tfagerholm/SIU-Scenery-Robot-V1/EET Research/Edge Detection Documents/Pictures/Dog collar disassembly/Step 2.PNG

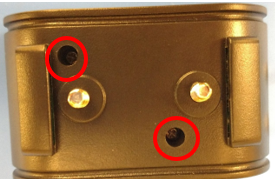
EET Research/Edge Detection Documents/Pictures/Dog collar disassembly/Step 2.PNG
