tfagerholm/SIU-Scenery-Robot-V1/Hardware/Jazzy Select motors & Wheels/Warner WR220 brakes.docx

Warner WR220 brakes

WR220 series brakes

FEATURES

The WR220 VAR22 brakes are an extremely compact design

Intended for use in static applications

1,5 Nm Torque

Maximum hub bore 10 mm

51,5 mm shell diameter

Manual release left or right, optional switch

Optional plastic lever cover

RoHS compliance

Typical Applications

Scooters/Wheelchairs

Patient hoists

Handheld power tools

Conveyors

Machine tools

Robotics

Floor sweepers/cleaners
