tfagerholm/SIU-Scenery-Robot-V1/Hardware/Jazzy Select motors & Wheels/GS35d 05-01&02.pdf

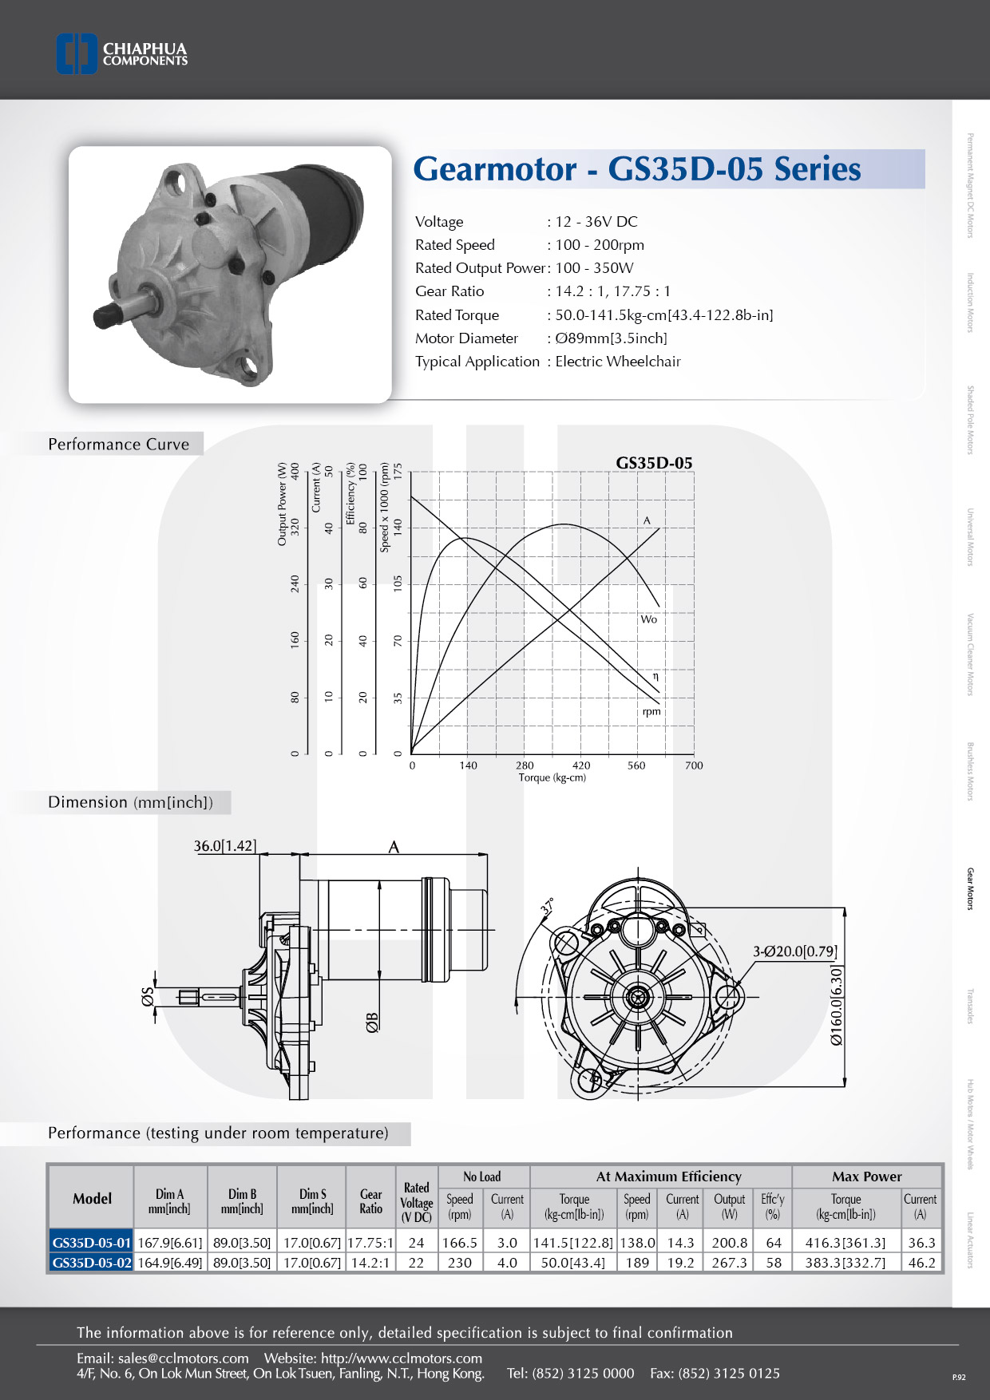
[picture p27: page 1]
