tfagerholm/SIU-Scenery-Robot-V1/Hardware/Jazzy Select motors & Wheels/GS35d 05.pdf

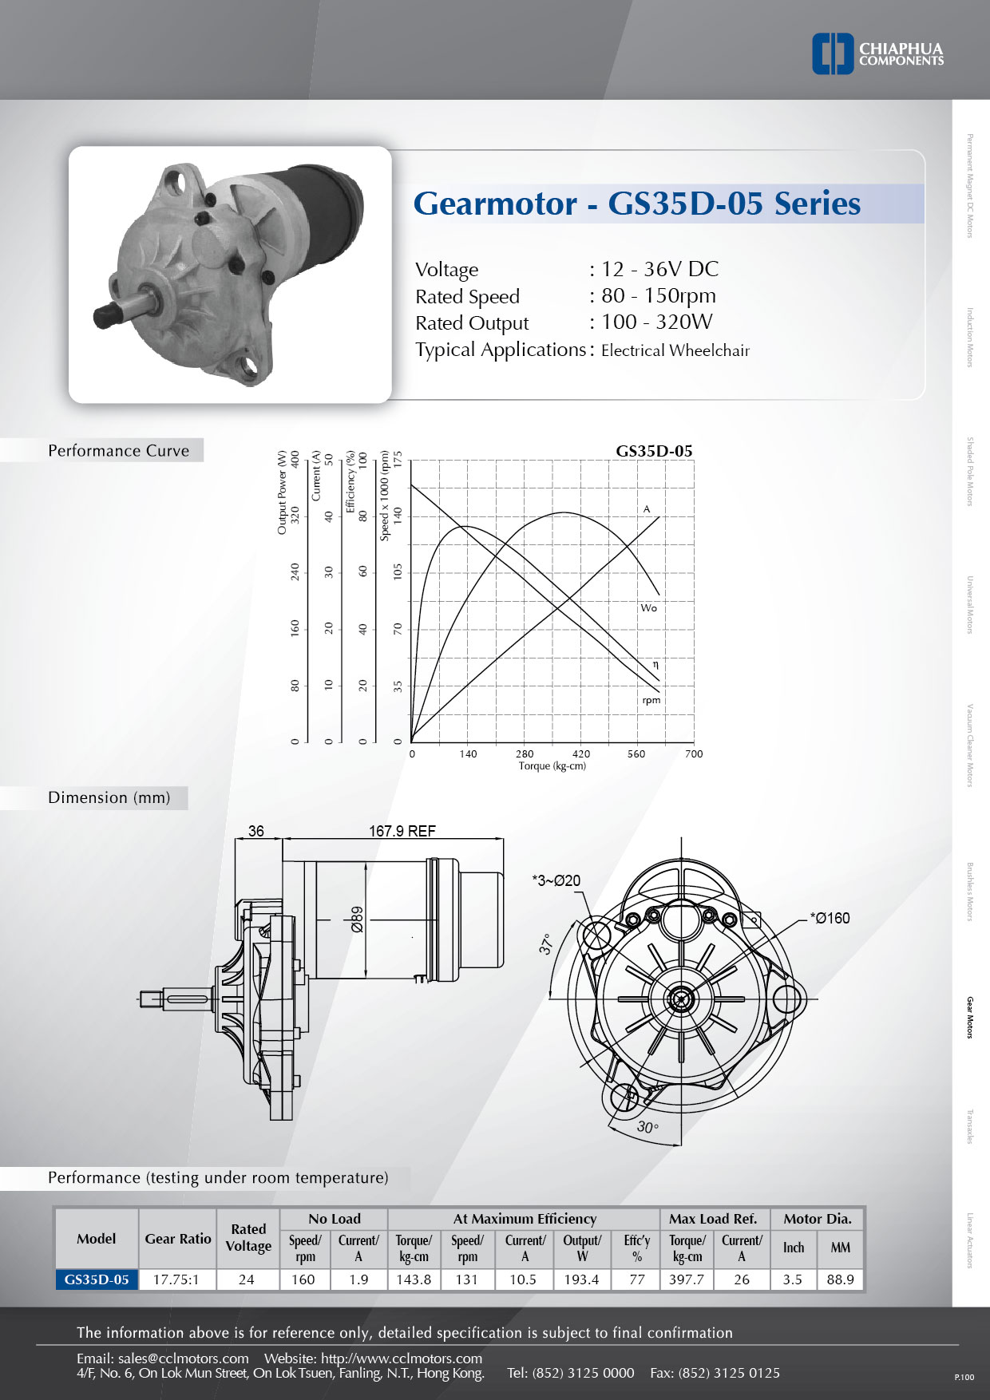
[picture p28: page 1]
