tfagerholm/SIU-Scenery-Robot-V1/EET Research/Connection Diagram.jpg

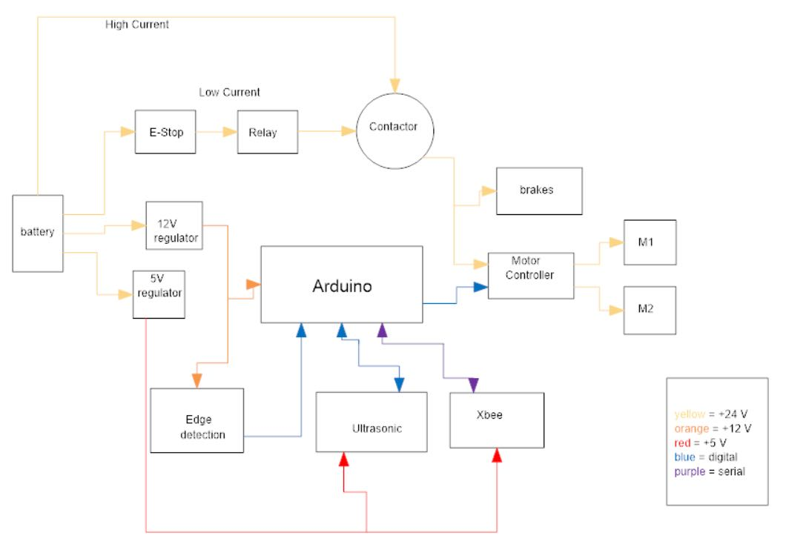
EET Research/Connection Diagram.jpg
