tfagerholm/SIU-Scenery-Robot-V1/EET Research/Edge Detection Documents/Pictures/Annotated board.PNG

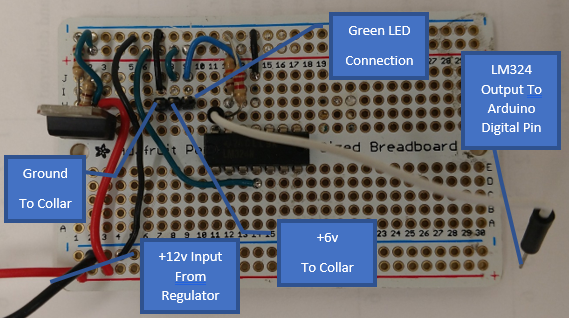
EET Research/Edge Detection Documents/Pictures/Annotated board.PNG
