tfagerholm/SIU-Scenery-Robot-V1/EET Research/Edge Detection Documents/Pictures/Annotated collar.PNG

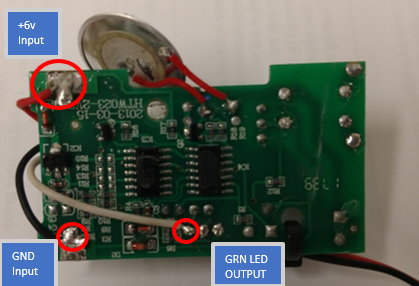
EET Research/Edge Detection Documents/Pictures/Annotated collar.PNG
