tfagerholm/SIU-Scenery-Robot-V1/EET Research/Edge Detection Documents/Pictures/IMG_20180507_153410372.jpg

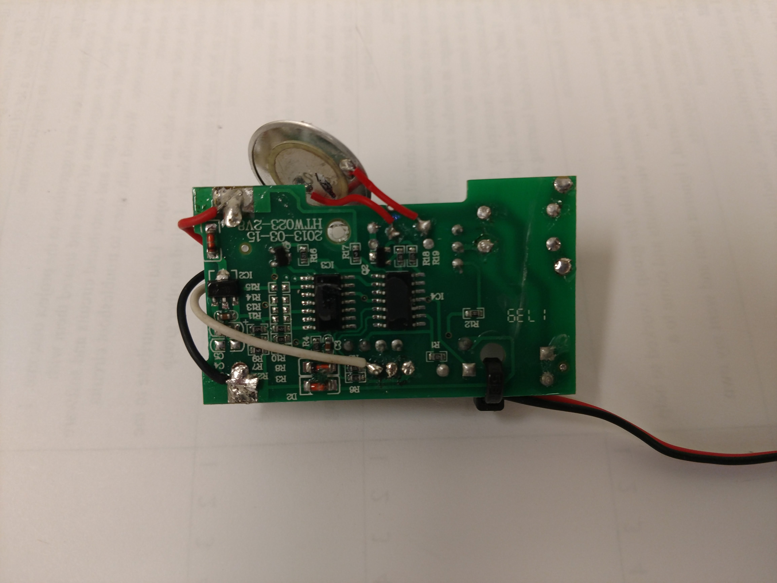
EET Research/Edge Detection Documents/Pictures/IMG_20180507_153410372.jpg
