tfagerholm/SIU-Scenery-Robot-V1/Photos/3D ISO of Frame.jpg

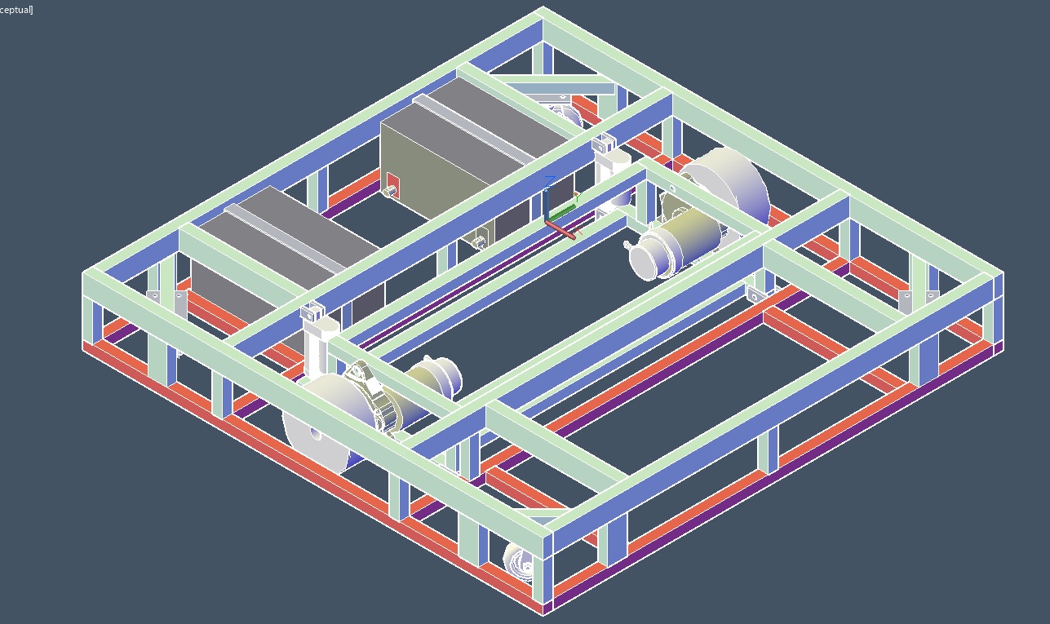
Photos/3D ISO of Frame.jpg
