tfagerholm/SIU-Scenery-Robot-V1/Photos/20190201_011459765_iOS.jpg

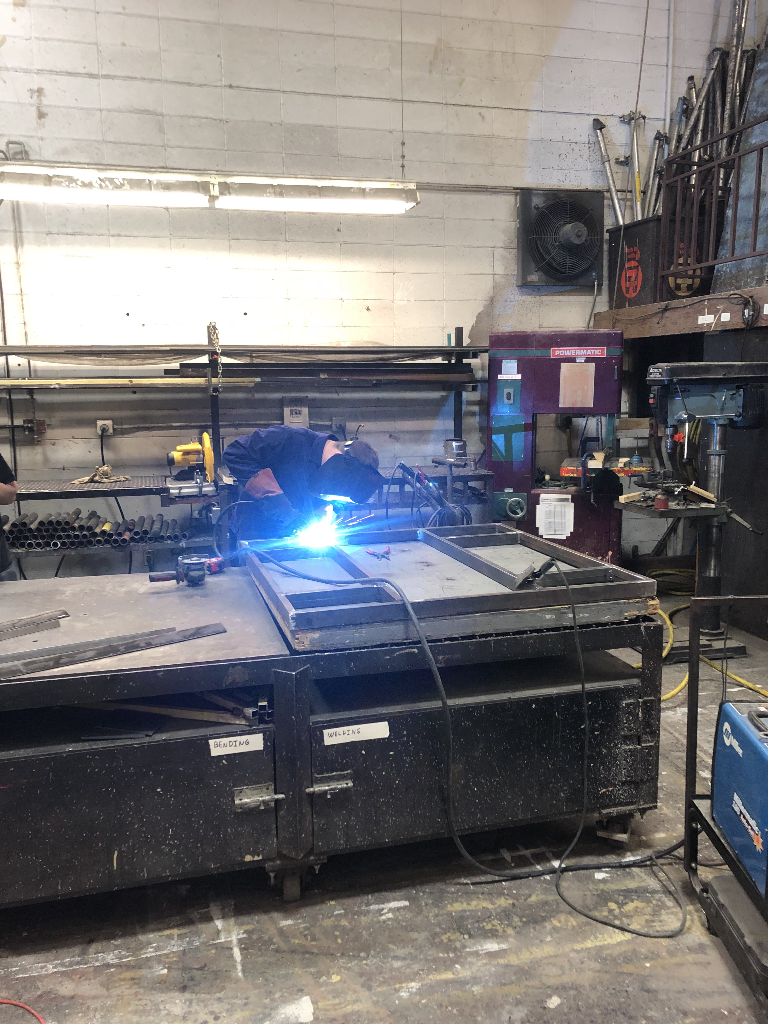
Photos/20190201_011459765_iOS.jpg
