tfagerholm/SIU-Scenery-Robot-V1/Photos/20190201_011505297_iOS.jpg

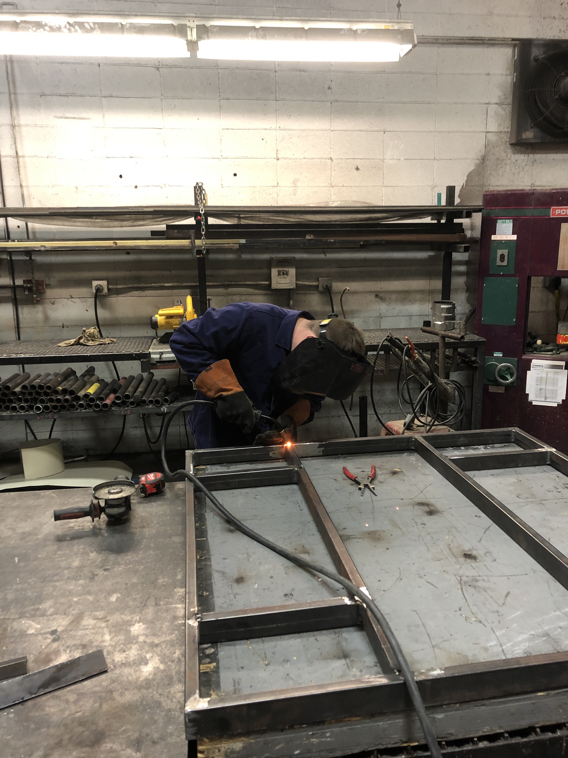
Photos/20190201_011505297_iOS.jpg
