tfagerholm/SIU-Scenery-Robot-V1/Photos/20190208_004331092_iOS.jpg

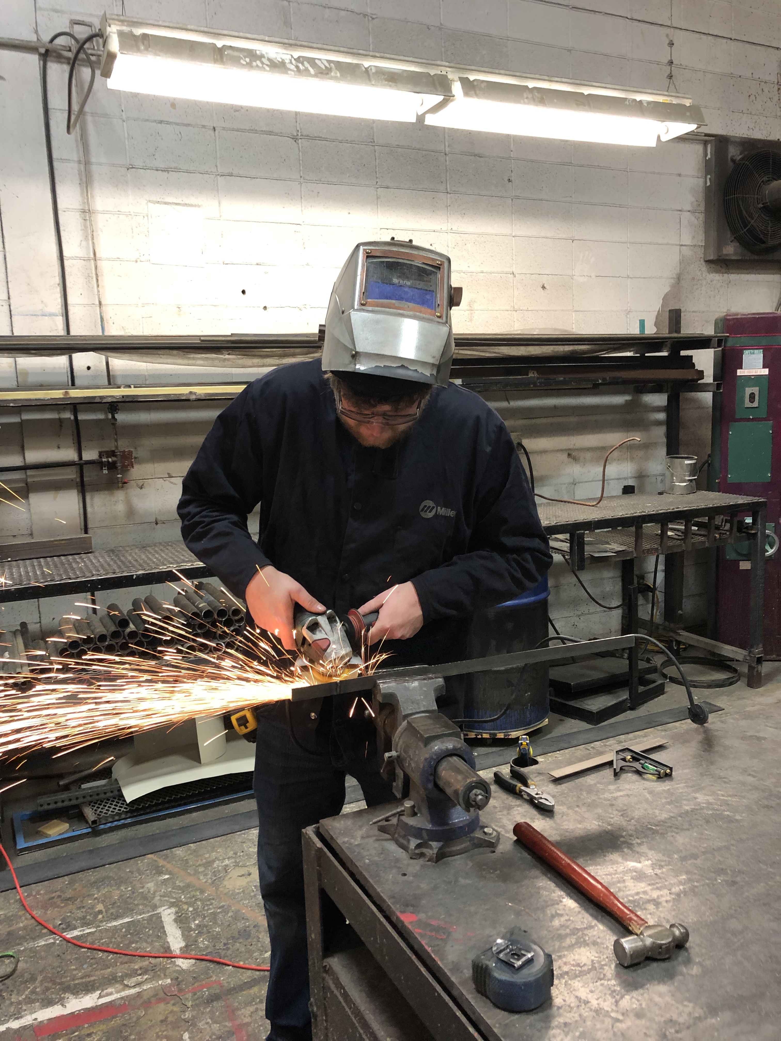
Photos/20190208_004331092_iOS.jpg
