tfagerholm/SIU-Scenery-Robot-V1/Photos/20190208_004505060_iOS.jpg

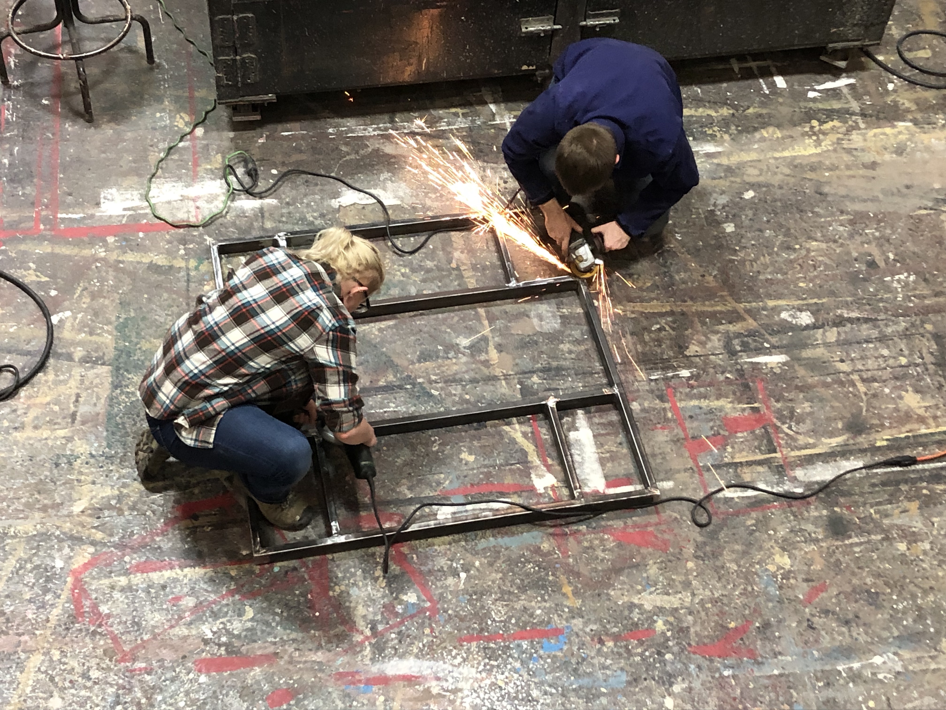
Photos/20190208_004505060_iOS.jpg
