tfagerholm/SIU-Scenery-Robot-V1/Photos/20190208_004511723_iOS.jpg

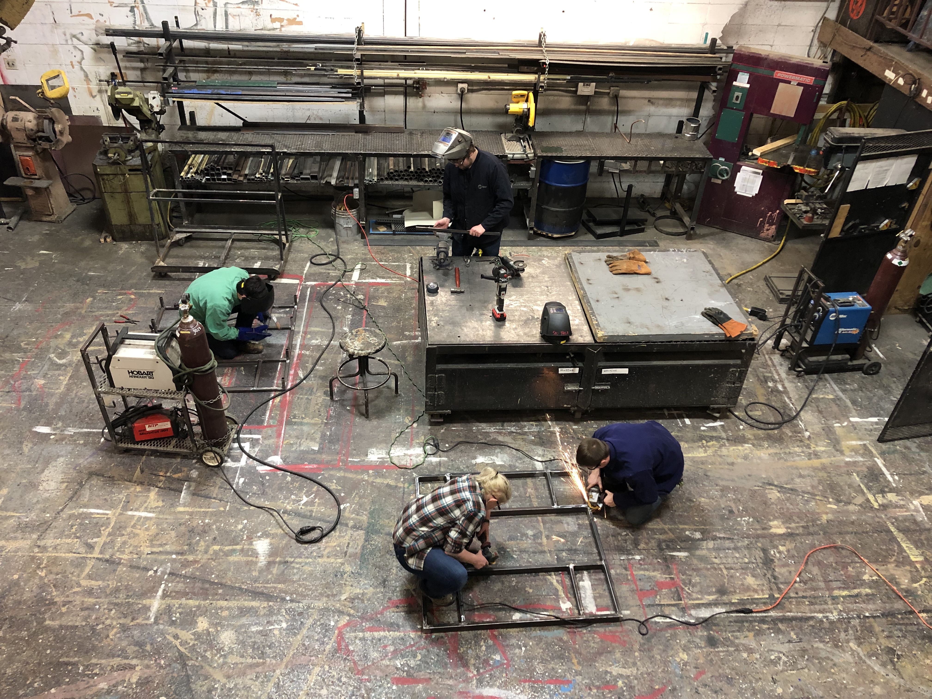
Photos/20190208_004511723_iOS.jpg
