tfagerholm/SIU-Scenery-Robot-V1/Photos/20190307_213836701_iOS.jpg

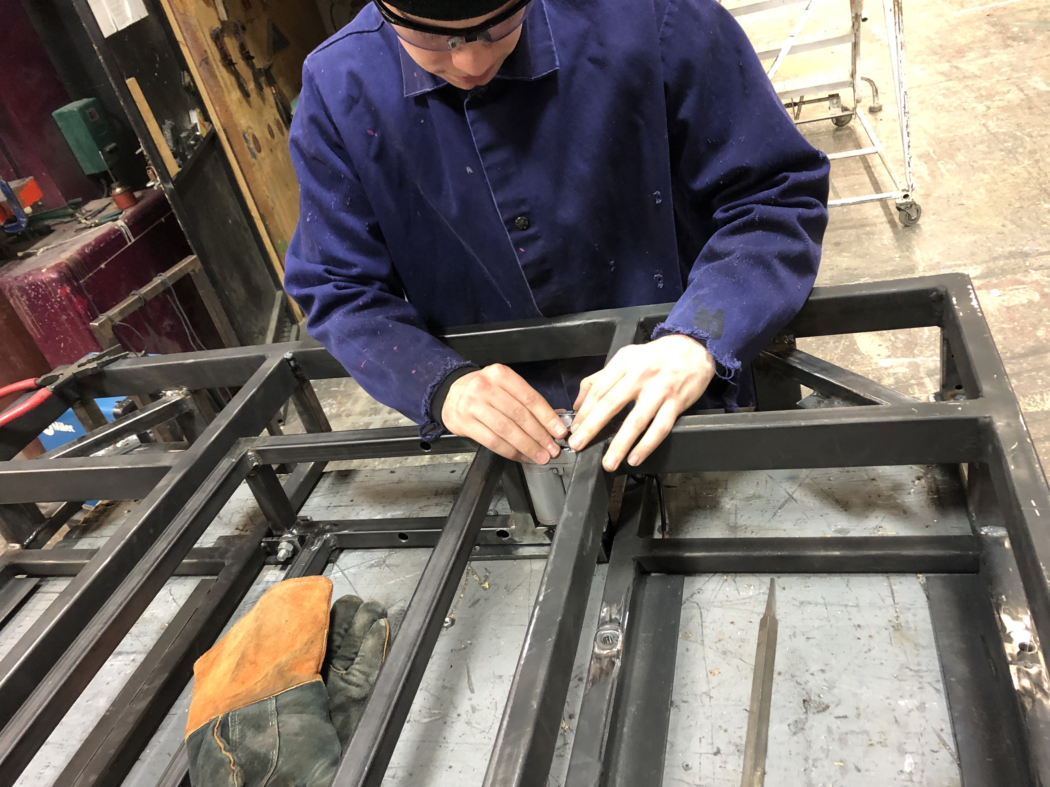
Photos/20190307_213836701_iOS.jpg
