tfagerholm/SIU-Scenery-Robot-V1/Photos/20190307_213838659_iOS.jpg

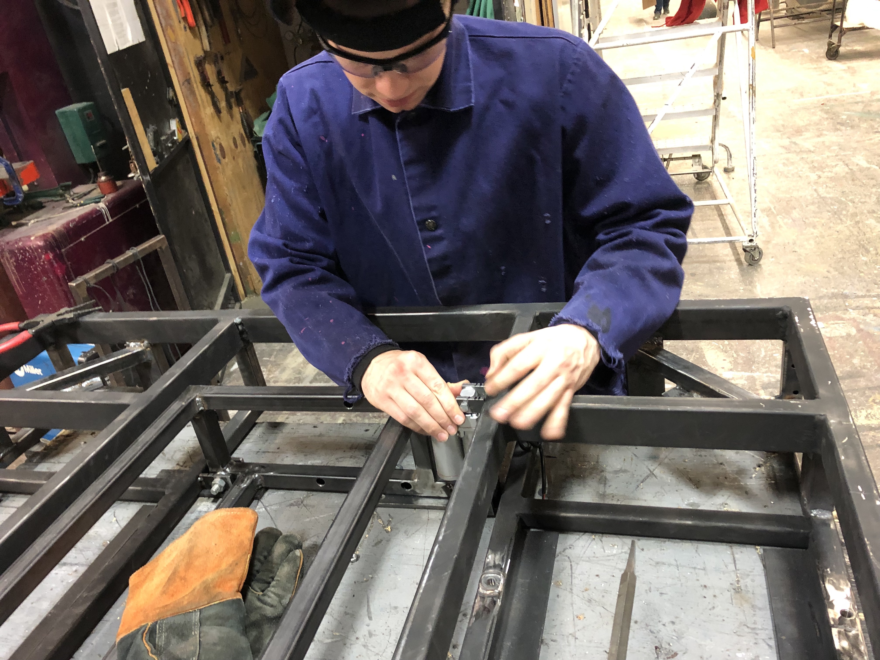
Photos/20190307_213838659_iOS.jpg
