tfagerholm/SIU-Scenery-Robot-V1/Photos/20190308_003058774_iOS.jpg

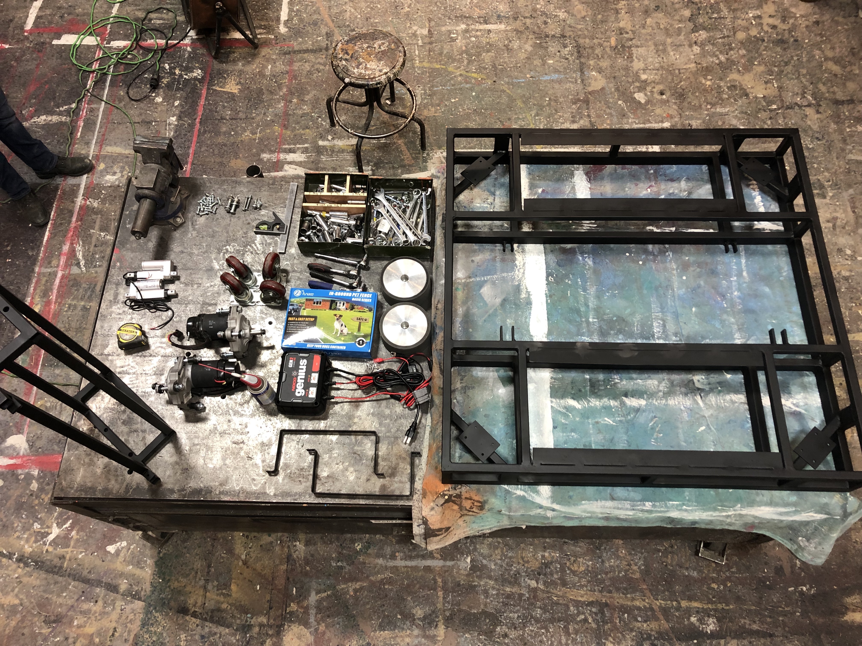
Photos/20190308_003058774_iOS.jpg
