tfagerholm/SIU-Scenery-Robot-V1/Photos/20190308_003123069_iOS.jpg

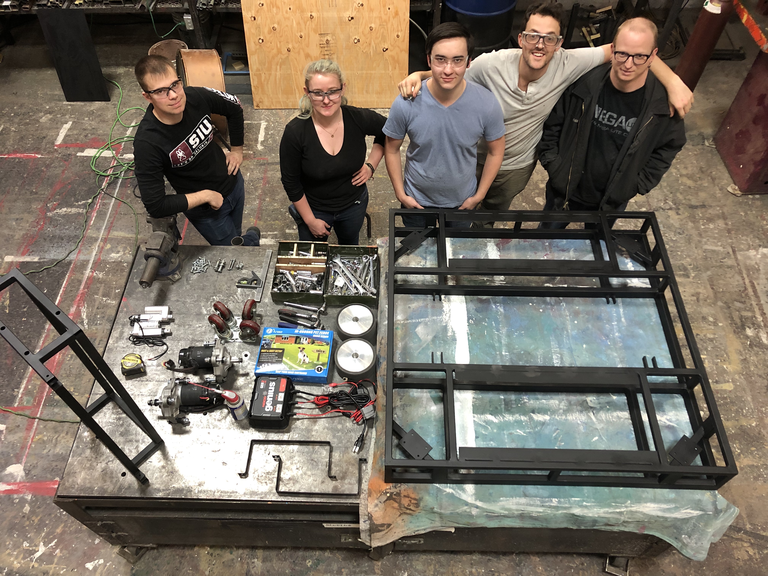
Photos/20190308_003123069_iOS.jpg
