tfagerholm/SIU-Scenery-Robot-V1/Photos/20190308_003128968_iOS.jpg

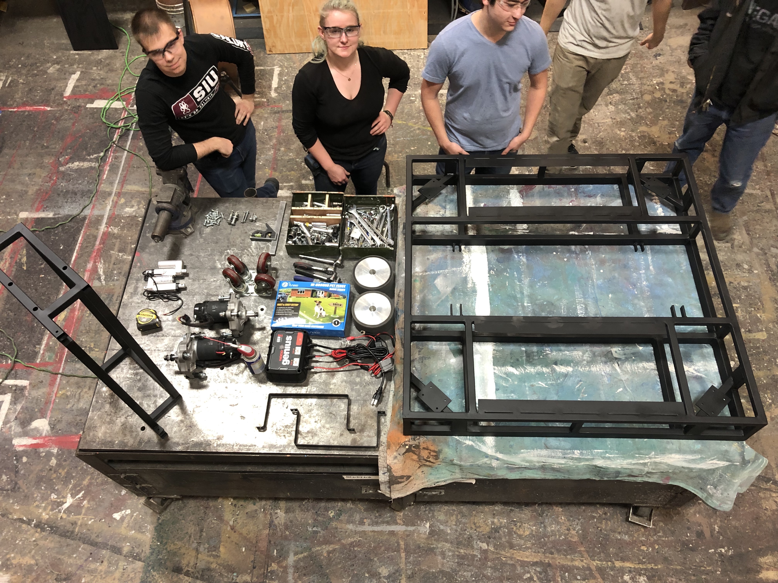
Photos/20190308_003128968_iOS.jpg
