tfagerholm/SIU-Scenery-Robot-V1/Photos/IMG_0376.JPG

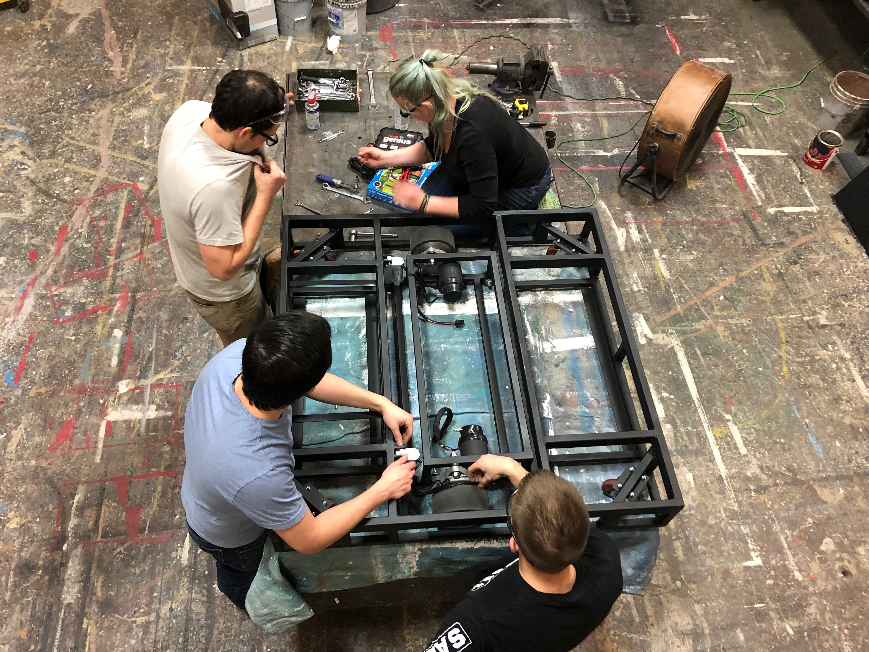
Photos/IMG_0376.JPG
