tfagerholm/SIU-Scenery-Robot-V1/Photos/IMG_0388.JPG

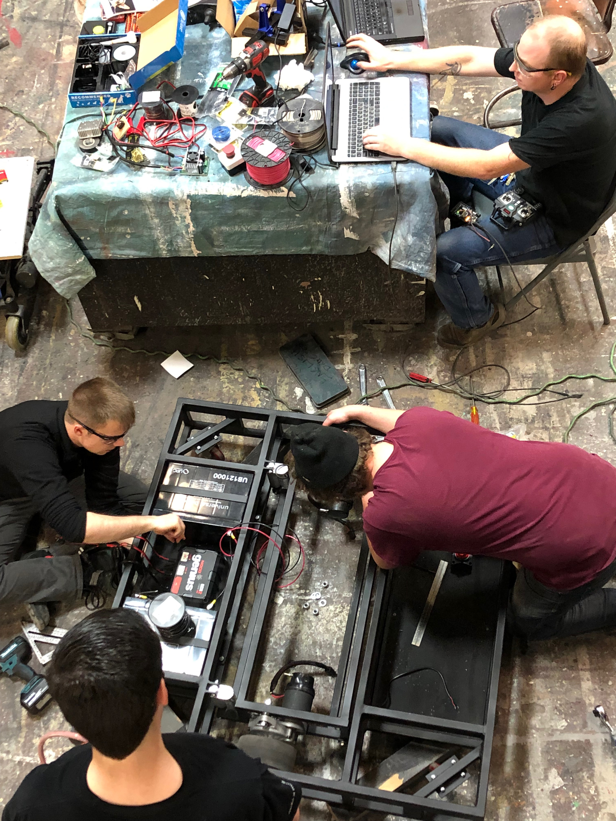
Photos/IMG_0388.JPG
