tfagerholm/SIU-Scenery-Robot-V1/Photos/IMG_0403.jpg

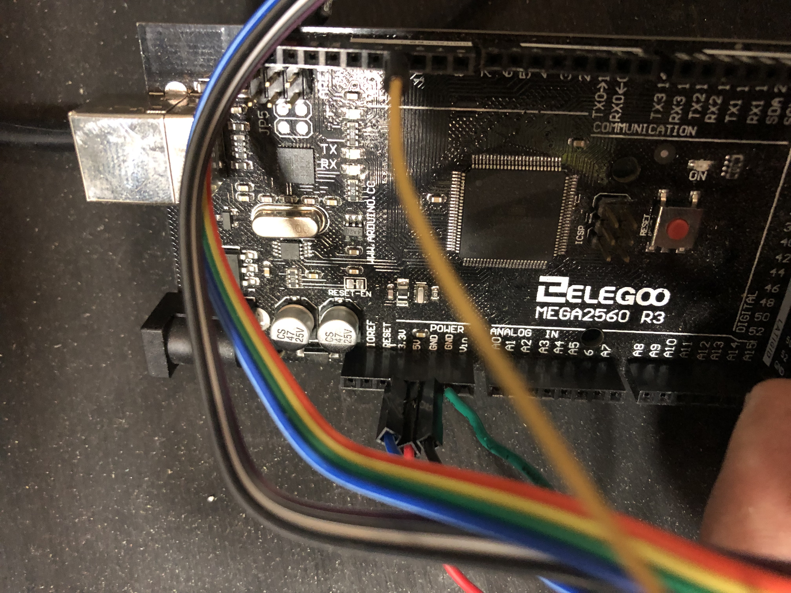
Photos/IMG_0403.jpg
