tfagerholm/SIU-Scenery-Robot-V1/Photos/IMG_0404.jpg

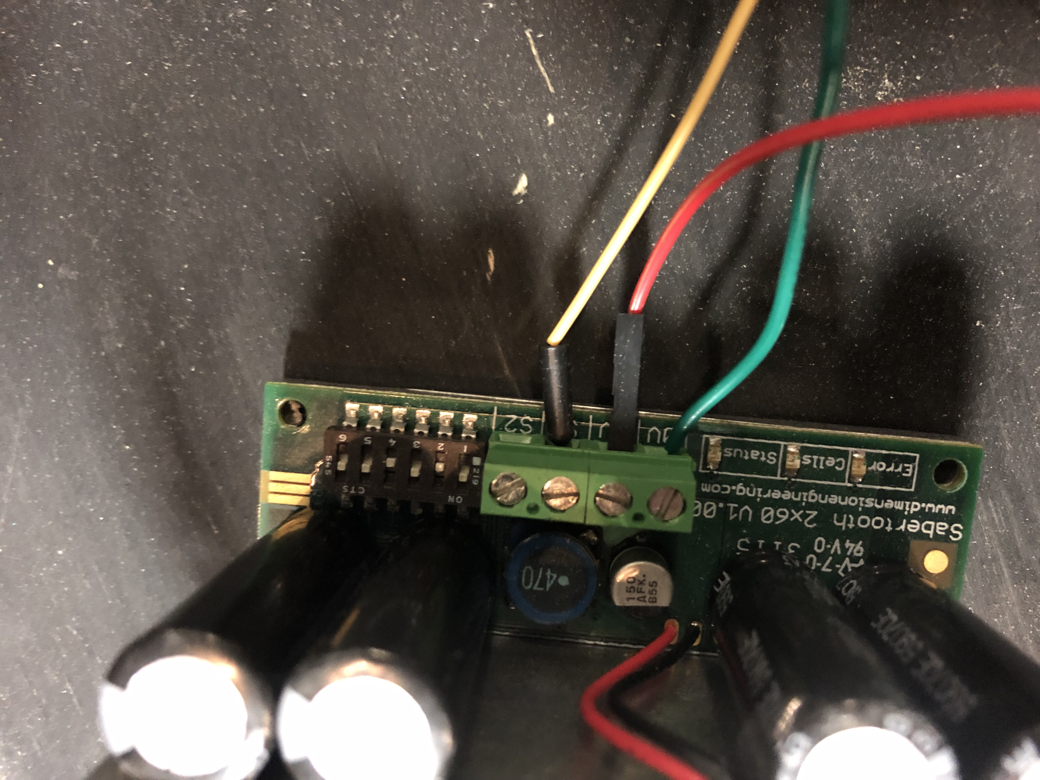
Photos/IMG_0404.jpg
