tfagerholm/SIU-Scenery-Robot-V1/Photos/IMG_0405.jpg

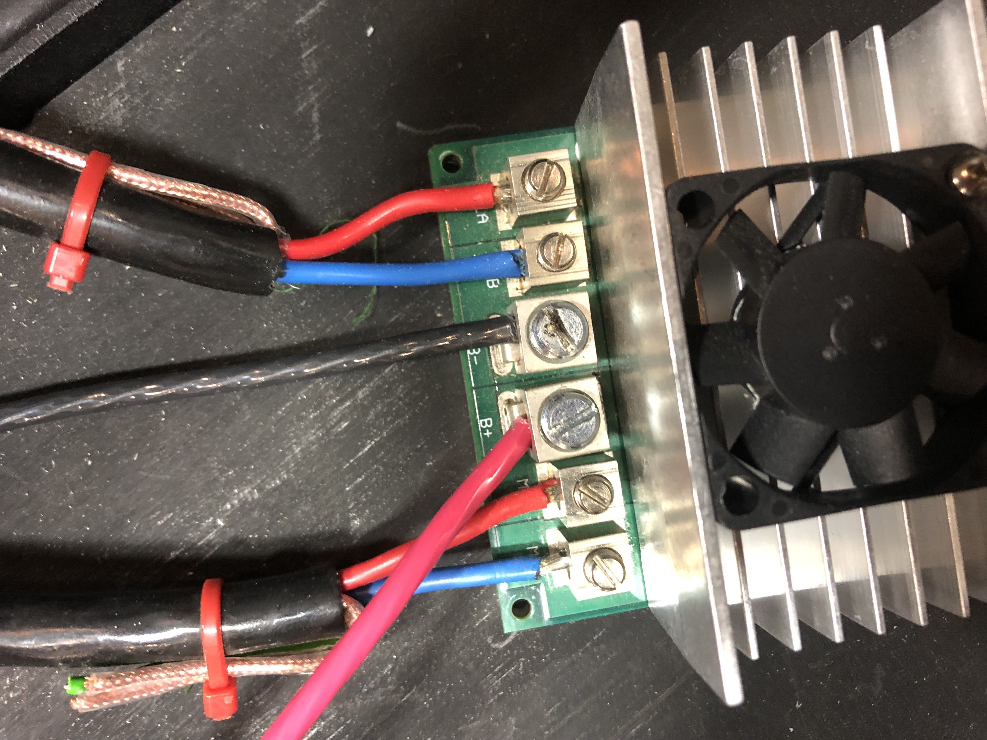
Photos/IMG_0405.jpg
