tfagerholm/SIU-Scenery-Robot-V1/Photos/IMG_0411.jpg

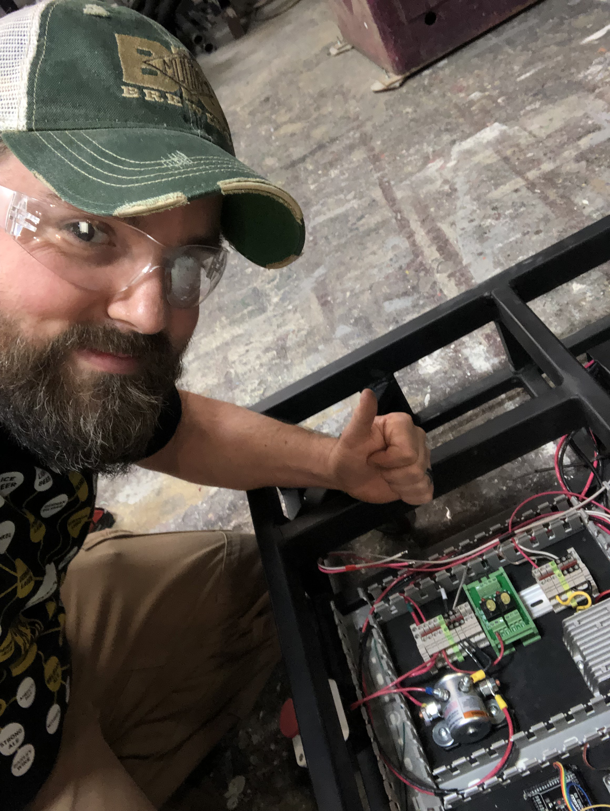
Photos/IMG_0411.jpg
