tfagerholm/SIU-Scenery-Robot-V1/Photos/IMG_0412(Edited).jpg

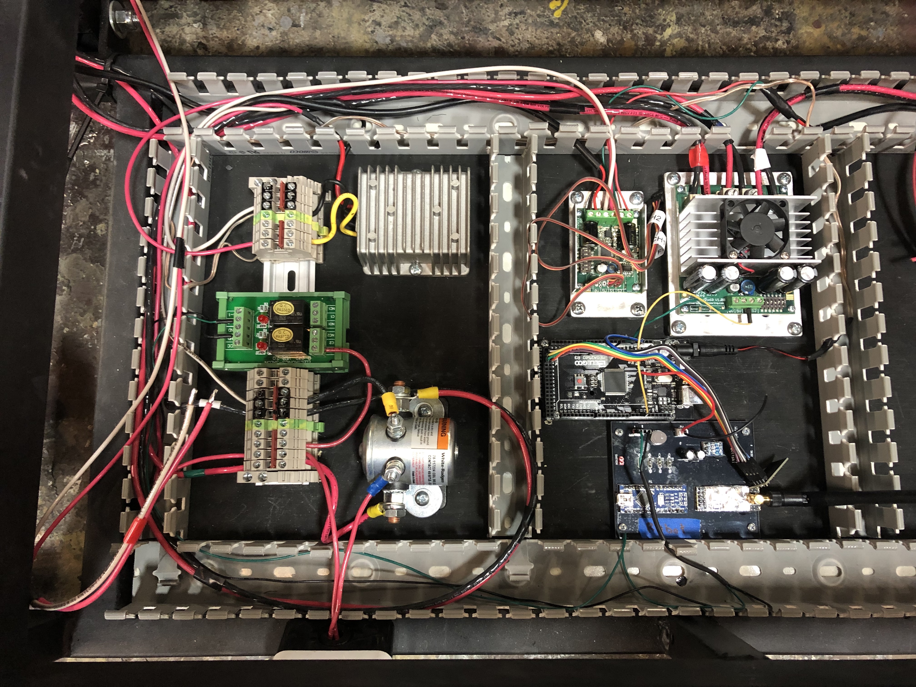
Photos/IMG_0412(Edited).jpg
