tfagerholm/SIU-Scenery-Robot-V1/Photos/IMG_0413(Edited).jpg

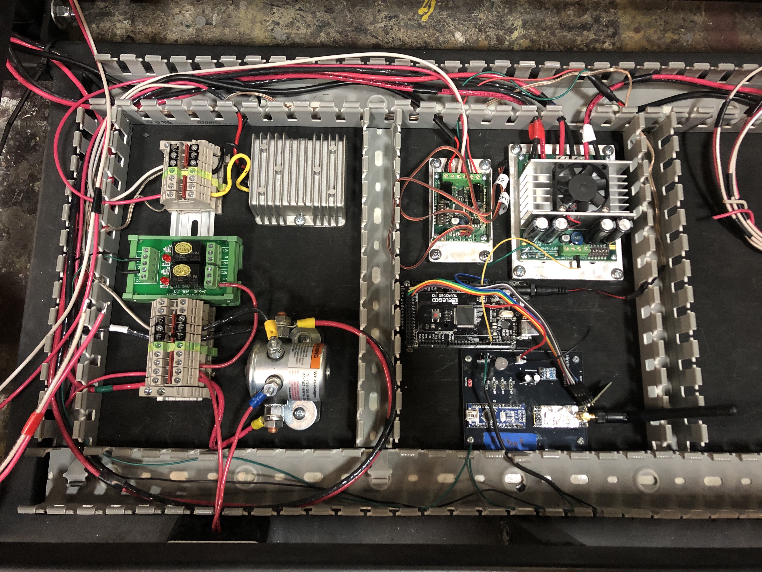
Photos/IMG_0413(Edited).jpg
