tfagerholm/SIU-Scenery-Robot-V1/Photos/IMG_0419.jpeg

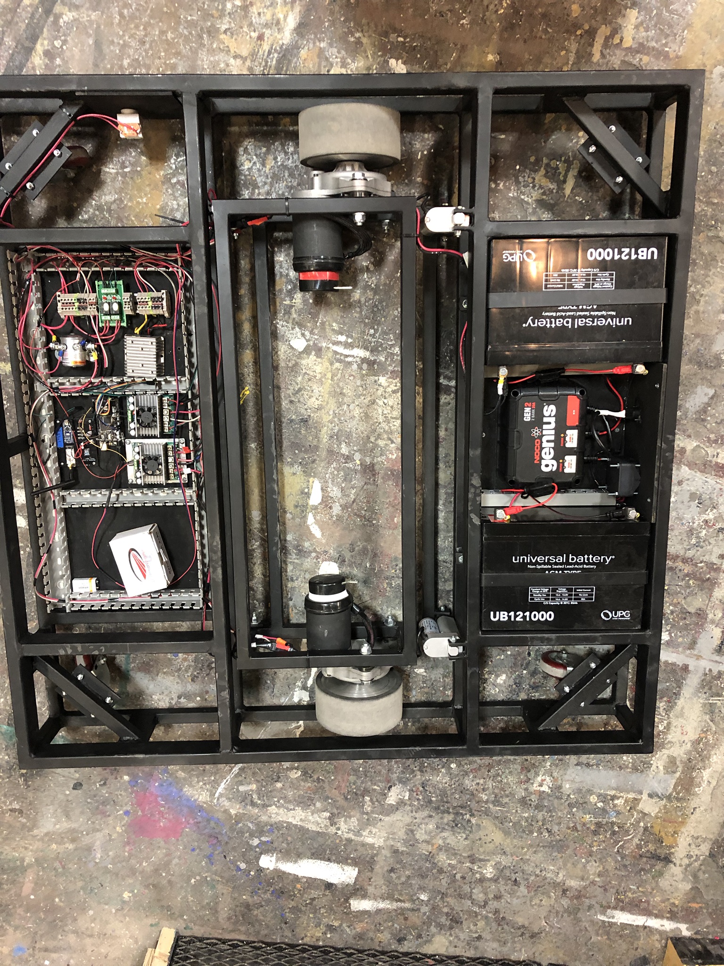
Photos/IMG_0419.jpeg
