tfagerholm/SIU-Scenery-Robot-V1/EET Research/Final Parts List for SP18.xlsx

Component Description | Part Use | Price | Quantity | Total | Link
Ring Terminals | Power Connections | $13.96 | 1 | 13.96 | https://www.amazon.com/Hilitchi-Insulated-Terminal-Electrical-Connectors/dp/B015HFHN0C
Buss Bar 5 Terminal | Power Connections | $16 | 4 | 64 | https://www.amazon.com/Blue-Sea-Systems-2315-Terminal/dp/B0009TUFWA
Buss Bar 10 Terminal | Power Connections | $14.51 | 1 | 14.51 | https://www.amazon.com/Blue-Sea-Systems-2315-Terminal/dp/B0091VHLW4
RJ11 Cable (2 Pack) | Ultrasonic Sensor Connections | $3.68 | 3 | 11.04 | https://www.amazon.com/Uxcell-Telephone-Straight-Cable-2-Pieces/dp/B00MJU3FLK?pldnSite=1
RJ11 Connectors (20 Pieces) | Ultrasonic Sensor Connections | $9.30 | 1 | 9.3 | https://smile.amazon.com/Vertical-Telephone-Adapter-20Pieces-Landline/dp/B00LUIRP7M?s=electronics
Relay | Arduino ESTOP Control | $5.80 | 1 | 5.8 | https://smile.amazon.com/Tolako-Arduino-Indicator-Channel-Official/dp/B00VRUAHLE
JST Connectors (20 Pairs) | Edge Detection Connection | $9.88 | 1 | 9.88 | https://smile.amazon.com/Mokungit-20-Pairs-JST-Connector/dp/B01AHJMR4A
Prototype Shield | Arduino Connections | $8.99 | 1 | 8.99 | https://www.amazon.com/RobotDyn-Protoshield-Prototype-breadboard-Pinheads/dp/B071ZRZ2VJ?pldnSite=1
5v Regulator | Supply 5v | $11.99 | 1 | 11.99 | https://www.amazon.com/Aweking-Waterproof-Converter-Regulator-Transformer/dp/B06WVLFYJH?s=electronics
12v Regulator | Supply 12v | $18.99 | 1 | 18.99 | https://www.amazon.com/dp/B00BWKXTUU
 |  |  | Total: | 168.46
Parts Needed
Battery Connectors
Charger?
Motor/Brake Connectors
