tfagerholm/SIU-Scenery-Robot-V1/Hardware/SIU Frame - 3D Assembly.pdf

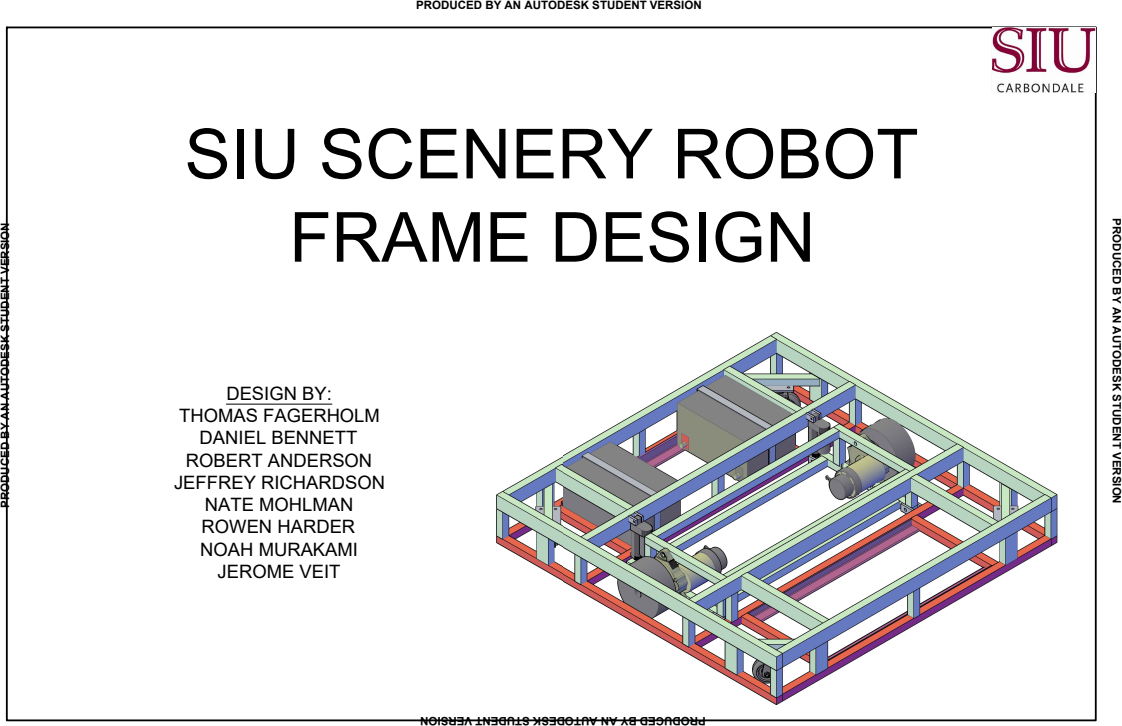
[picture p78: page 1]

PRODUCED BY AN AUTODESK STUDENT VERSION

SIU SCENERY ROBOT FRAME DESIGN DESIGN BY: THOMAS FAGERHOLM DANIEL BENNETT ROBERT ANDERSON JEFFREY RICHARDSON NATE MOHLMAN ROWEN HARDER NOAH MURAKAMI JEROME VEIT

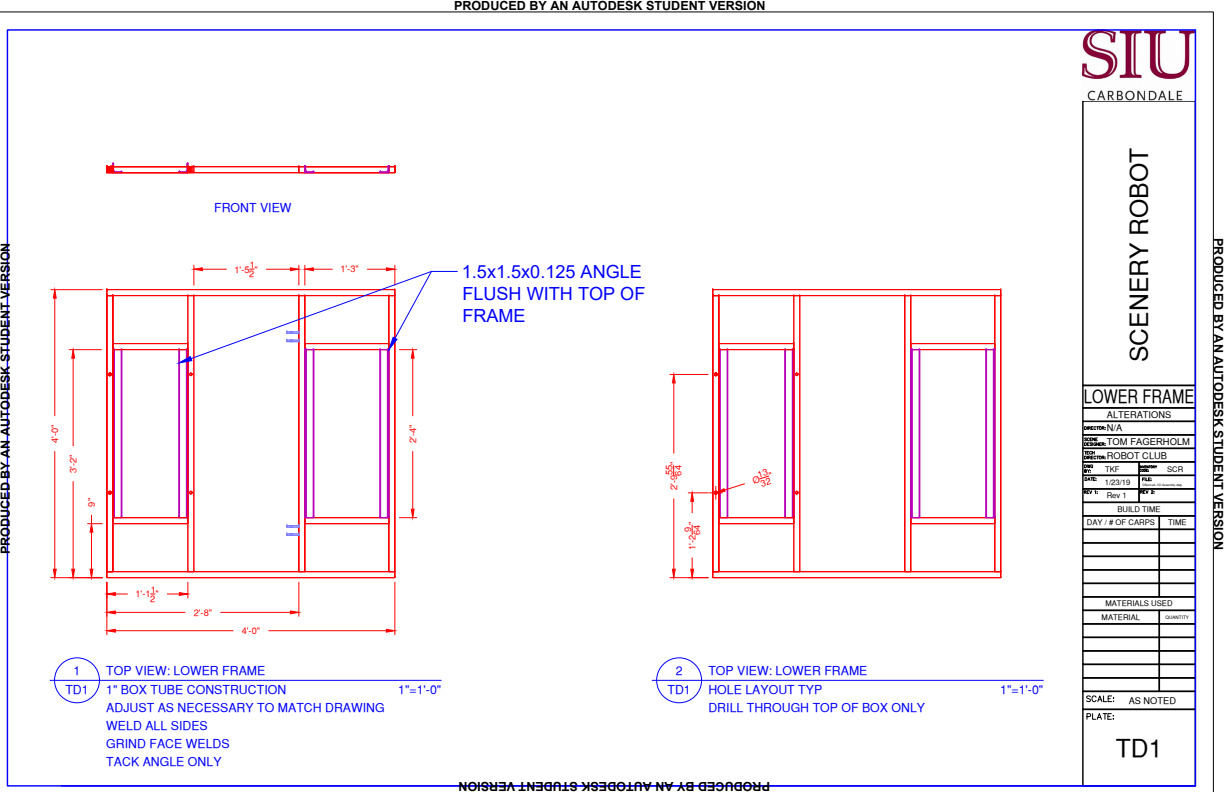
[picture p79: page 2]
MATERIAL; QUANTITY BUILD TIME DAY / # OF CARPS; TIME MATERIALS USED

PRODUCED BY AN AUTODESK STUDENT VERSION

SCENERY ROBOT N/A ROBOT CLUB DBennett- 3D Assembly.dwg TOM FAGERHOLM TD1 AS NOTED Rev 1 1/23/19 TKF LOWER FRAME ALTERATIONSSCR

2'-4" 1'-512" 1'-3" 1.5x1.5x0.125 ANGLE FLUSH WITH TOP OF FRAME TD11 1" BOX TUBE CONSTRUCTION TOP VIEW: LOWER FRAME 1"=1'-0" ADJUST AS NECESSARY TO MATCH DRAWING WELD ALL SIDES GRIND FACE WELDS TACK ANGLE ONLYFRONT VIEW Ø1332" 1'-2 9

64" TD12 HOLE LAYOUT TYP TOP VIEW: LOWER FRAME 1"=1'-0" DRILL THROUGH TOP OF BOX ONLY

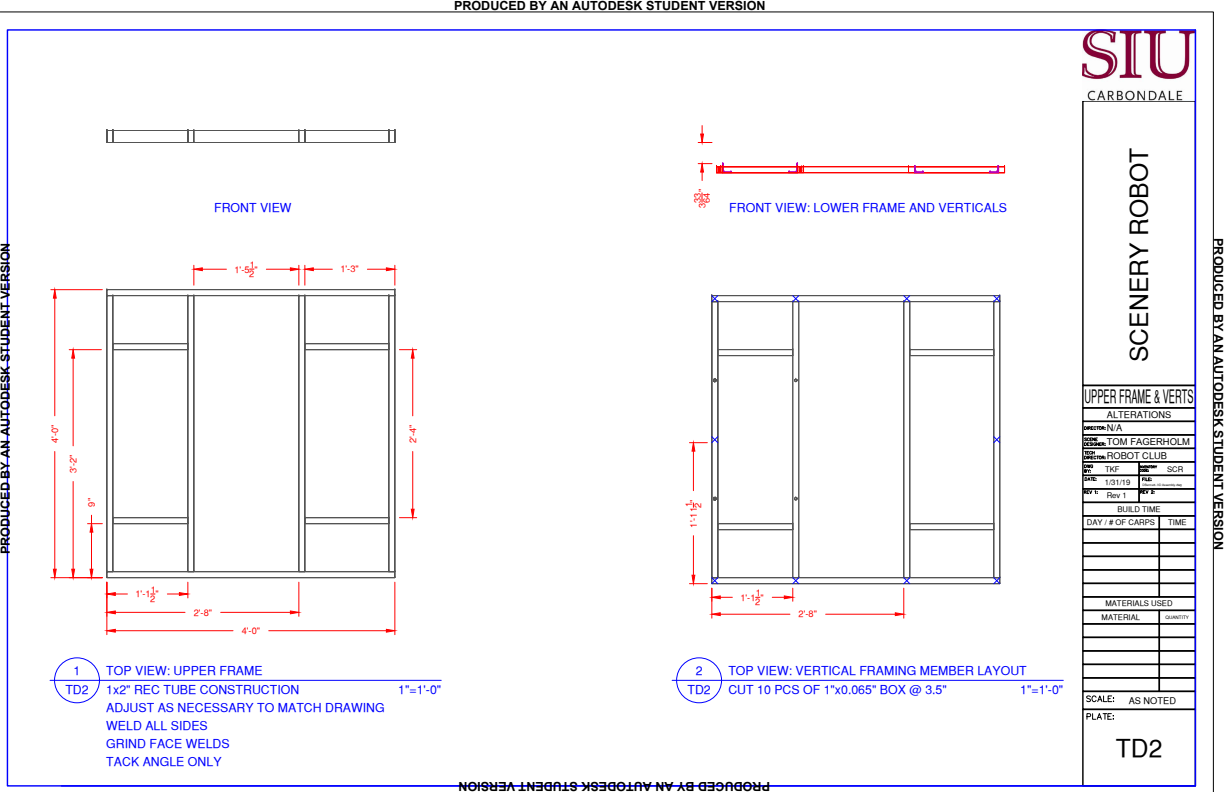
[picture p80: page 3]
MATERIAL; QUANTITY BUILD TIME DAY / # OF CARPS; TIME MATERIALS USED

PRODUCED BY AN AUTODESK STUDENT VERSION

SCENERY ROBOT N/A ROBOT CLUB DBennett- 3D Assembly.dwg TOM FAGERHOLM TD2 AS NOTED Rev 1 1/31/19 TKF UPPER FRAME & VERTS ALTERATIONSSCR

2'-4" 1'-512" 1'-3" TD21 1x2" REC TUBE CONSTRUCTION TOP VIEW: UPPER FRAME 1"=1'-0" ADJUST AS NECESSARY TO MATCH DRAWING WELD ALL SIDES GRIND FACE WELDS TACK ANGLE ONLYFRONT VIEW TD22 CUT 10 PCS OF 1"x0.065" BOX @ 3.5" TOP VIEW: VERTICAL FRAMING MEMBER LAYOUT1"=1'-0"

1'-1112" 1'-112" 2'-8" FRONT VIEW: LOWER FRAME AND VERTICALS 3

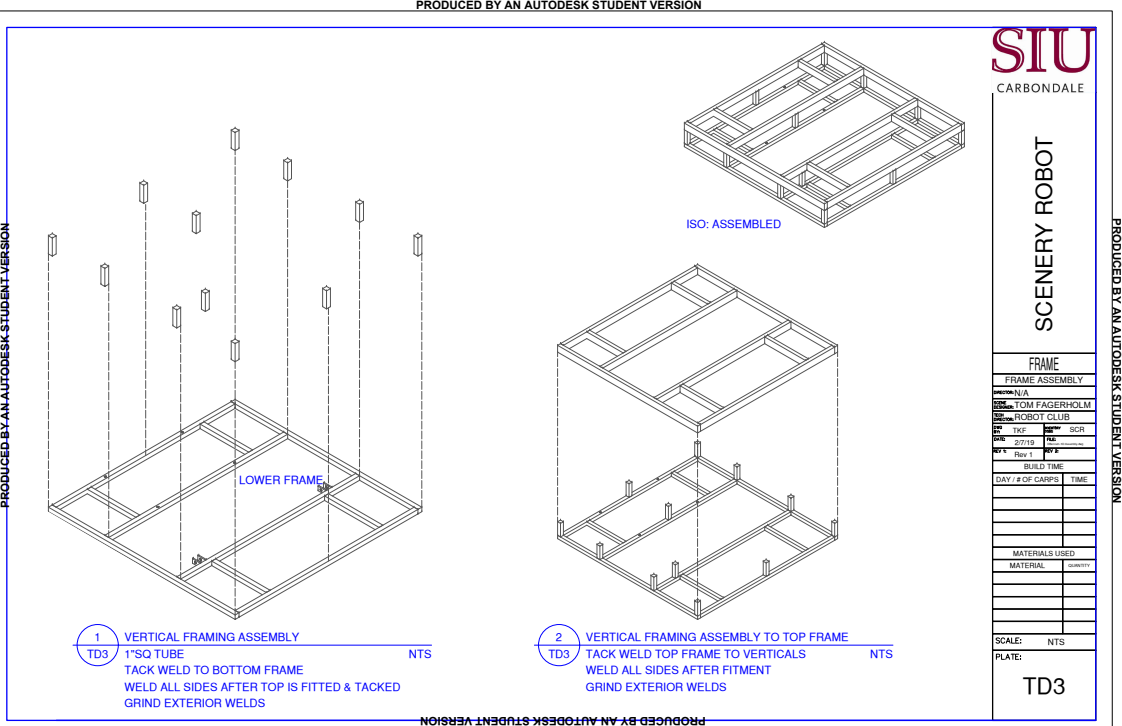
[picture p81: page 4]
MATERIAL; QUANTITY BUILD TIME DAY / # OF CARPS; TIME MATERIALS USED

PRODUCED BY AN AUTODESK STUDENT VERSION

SCENERY ROBOT N/A ROBOT CLUB DBennett- 3D Assembly.dwg TOM FAGERHOLM TD3NTS Rev 1 2/7/19 TKF FRAME FRAME ASSEMBLY SCR TD31 1"SQ TUBE VERTICAL FRAMING ASSEMBLY NTS TACK WELD TO BOTTOM FRAME WELD ALL SIDES AFTER TOP IS FITTED & TACKED GRIND EXTERIOR WELDS ISO: ASSEMBLED TD32 TACK WELD TOP FRAME TO VERTICALS VERTICAL FRAMING ASSEMBLY TO TOP FRAME NTS WELD ALL SIDES AFTER FITMENT GRIND EXTERIOR WELDS LOWER FRAME

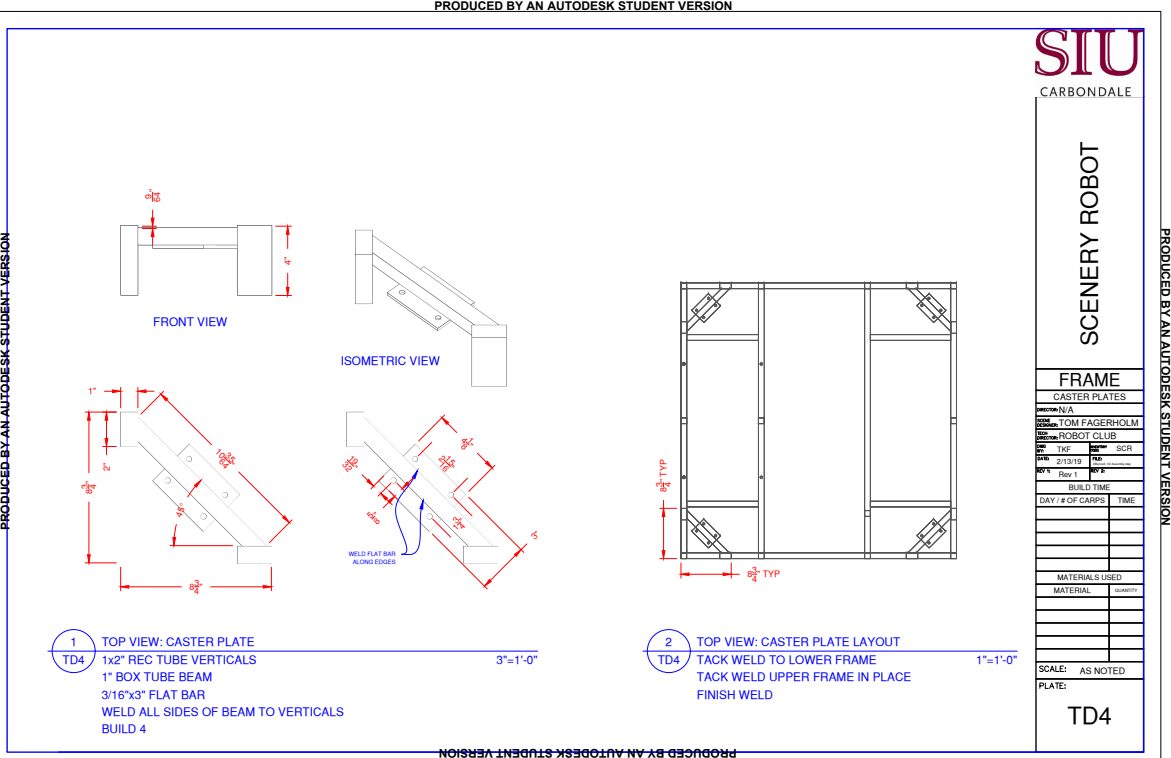
[picture p82: page 5]
MATERIAL; QUANTITY BUILD TIME DAY / # OF CARPS; TIME MATERIALS USED; " TYP 58"

PRODUCED BY AN AUTODESK STUDENT VERSION

SCENERY ROBOT N/A ROBOT CLUB DBennett- 3D Assembly.dwg TOM FAGERHOLM TD4 AS NOTED Rev 1 2/13/19 TKF FRAME CASTER PLATESSCR TD41 1x2" REC TUBE VERTICALS TOP VIEW: CASTER PLATE 3"=1'-0" 1" BOX TUBE BEAM 3/16"x3" FLAT BAR WELD ALL SIDES OF BEAM TO VERTICALS BUILD 4 FRONT VIEW TD42 TACK WELD TO LOWER FRAME TOP VIEW: CASTER PLATE LAYOUT 1"=1'-0" TACK WELD UPPER FRAME IN PLACE FINISH WELD

64" 834" 834" ISOMETRIC VIEW 834" TYP 834

2" 103564" 1" 45° 21516" 418" 134" 3" WELD FLAT BAR ALONG EDGES 1932"

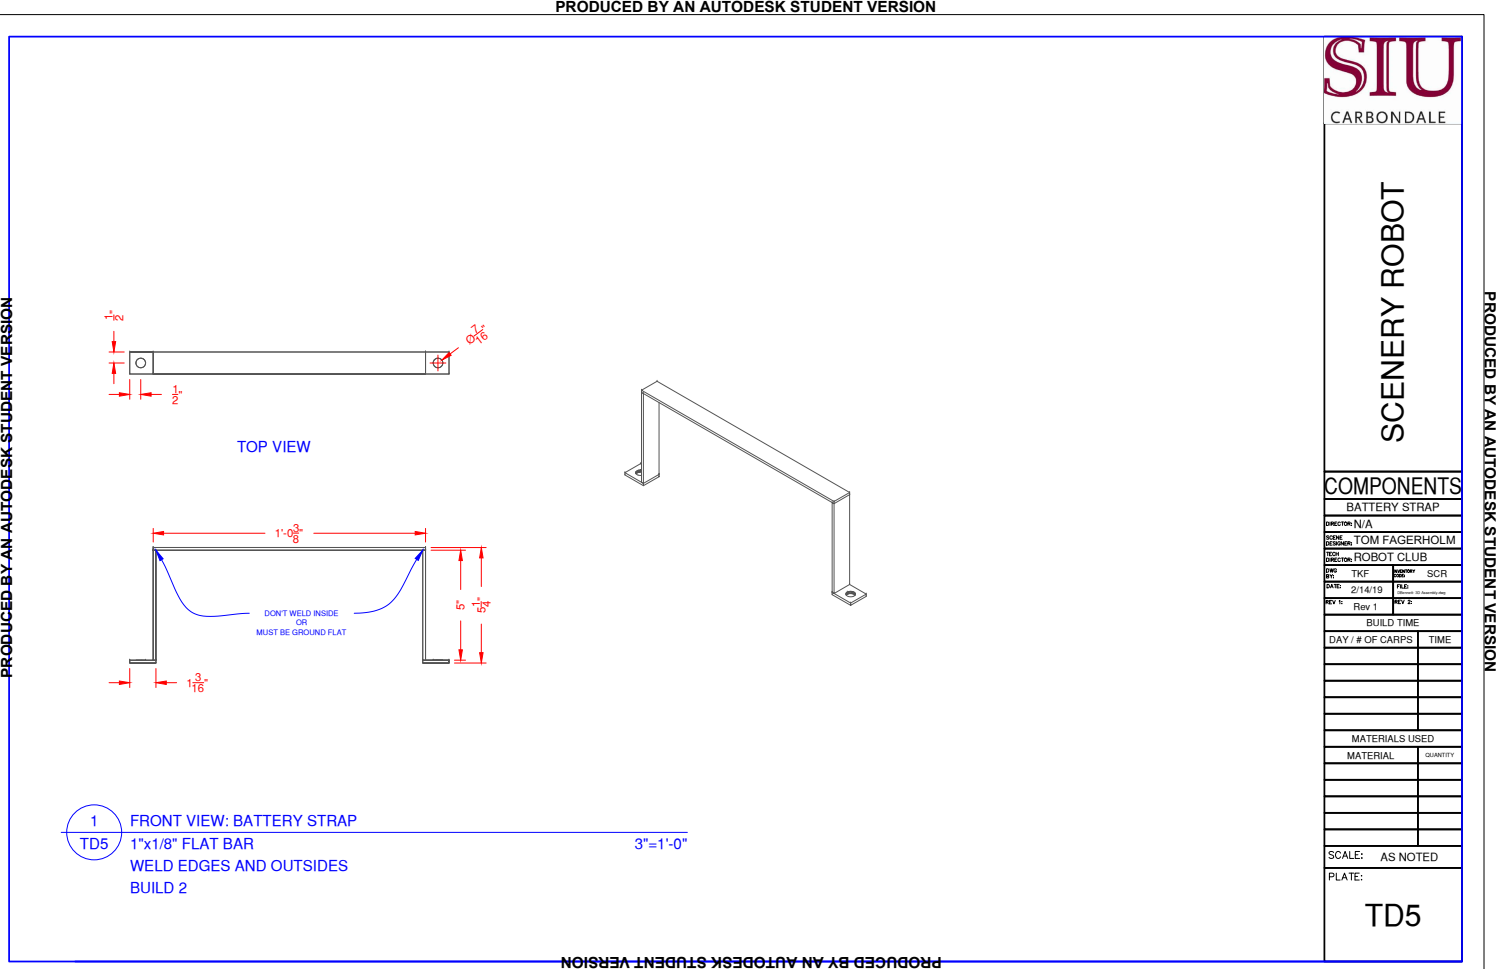
[picture p83: page 6]
MATERIAL; QUANTITY BUILD TIME DAY / # OF CARPS; TIME MATERIALS USED; 1"x1/8" FLAT BAR FRONT VIEW: BATTERY STRAP; 3"=1'-0" WELD EDGES AND OUTSIDES BUILD 2; TOP VIEW

PRODUCED BY AN AUTODESK STUDENT VERSION

SCENERY ROBOT N/A ROBOT CLUB DBennett- 3D Assembly.dwg TOM FAGERHOLM TD5 AS NOTED Rev 1 2/14/19 TKF COMPONENTS BATTERY STRAPSCR TD5

" DON'T WELD INSIDE OR MUST BE GROUND FLAT

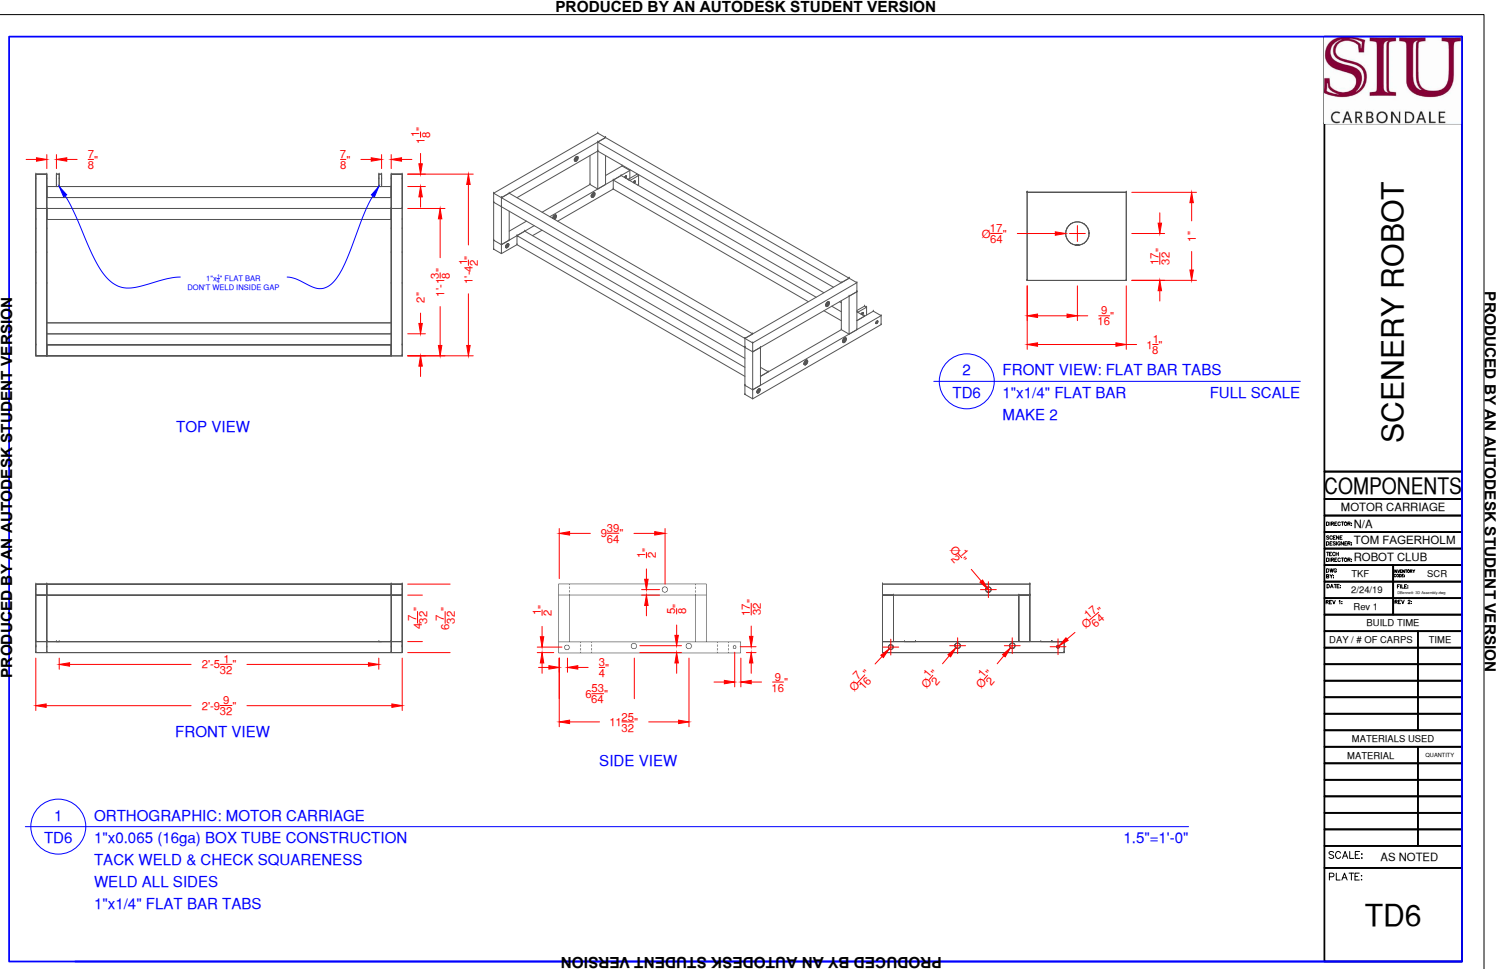
[picture p84: page 7]
MATERIAL; QUANTITY BUILD TIME DAY / # OF CARPS; TIME MATERIALS USED

PRODUCED BY AN AUTODESK STUDENT VERSION

SCENERY ROBOT N/A ROBOT CLUB DBennett- 3D Assembly.dwg TOM FAGERHOLM TD6 AS NOTED Rev 1 2/24/19 TKF COMPONENTS MOTOR CARRIAGE SCR TD61 1"x0.065 (16ga) BOX TUBE CONSTRUCTION ORTHOGRAPHIC: MOTOR CARRIAGE 1.5"=1'-0" TACK WELD & CHECK SQUARENESS WELD ALL SIDES 1"x1/4" FLAT BAR TABS TOP VIEW 1"x14" FLAT BAR DON'T WELD INSIDE GAP 2'-5 132" 2'-9 932" 4 7

1"1764" TD62 1"x1/4" FLAT BAR FRONT VIEW: FLAT BAR TABSFULL SCALE MAKE 2

32" 12" 34" 65364"112532" 93964" 916" Ø 716" Ø12" Ø12" Ø12" Ø1764" FRONT VIEW SIDE VIEW

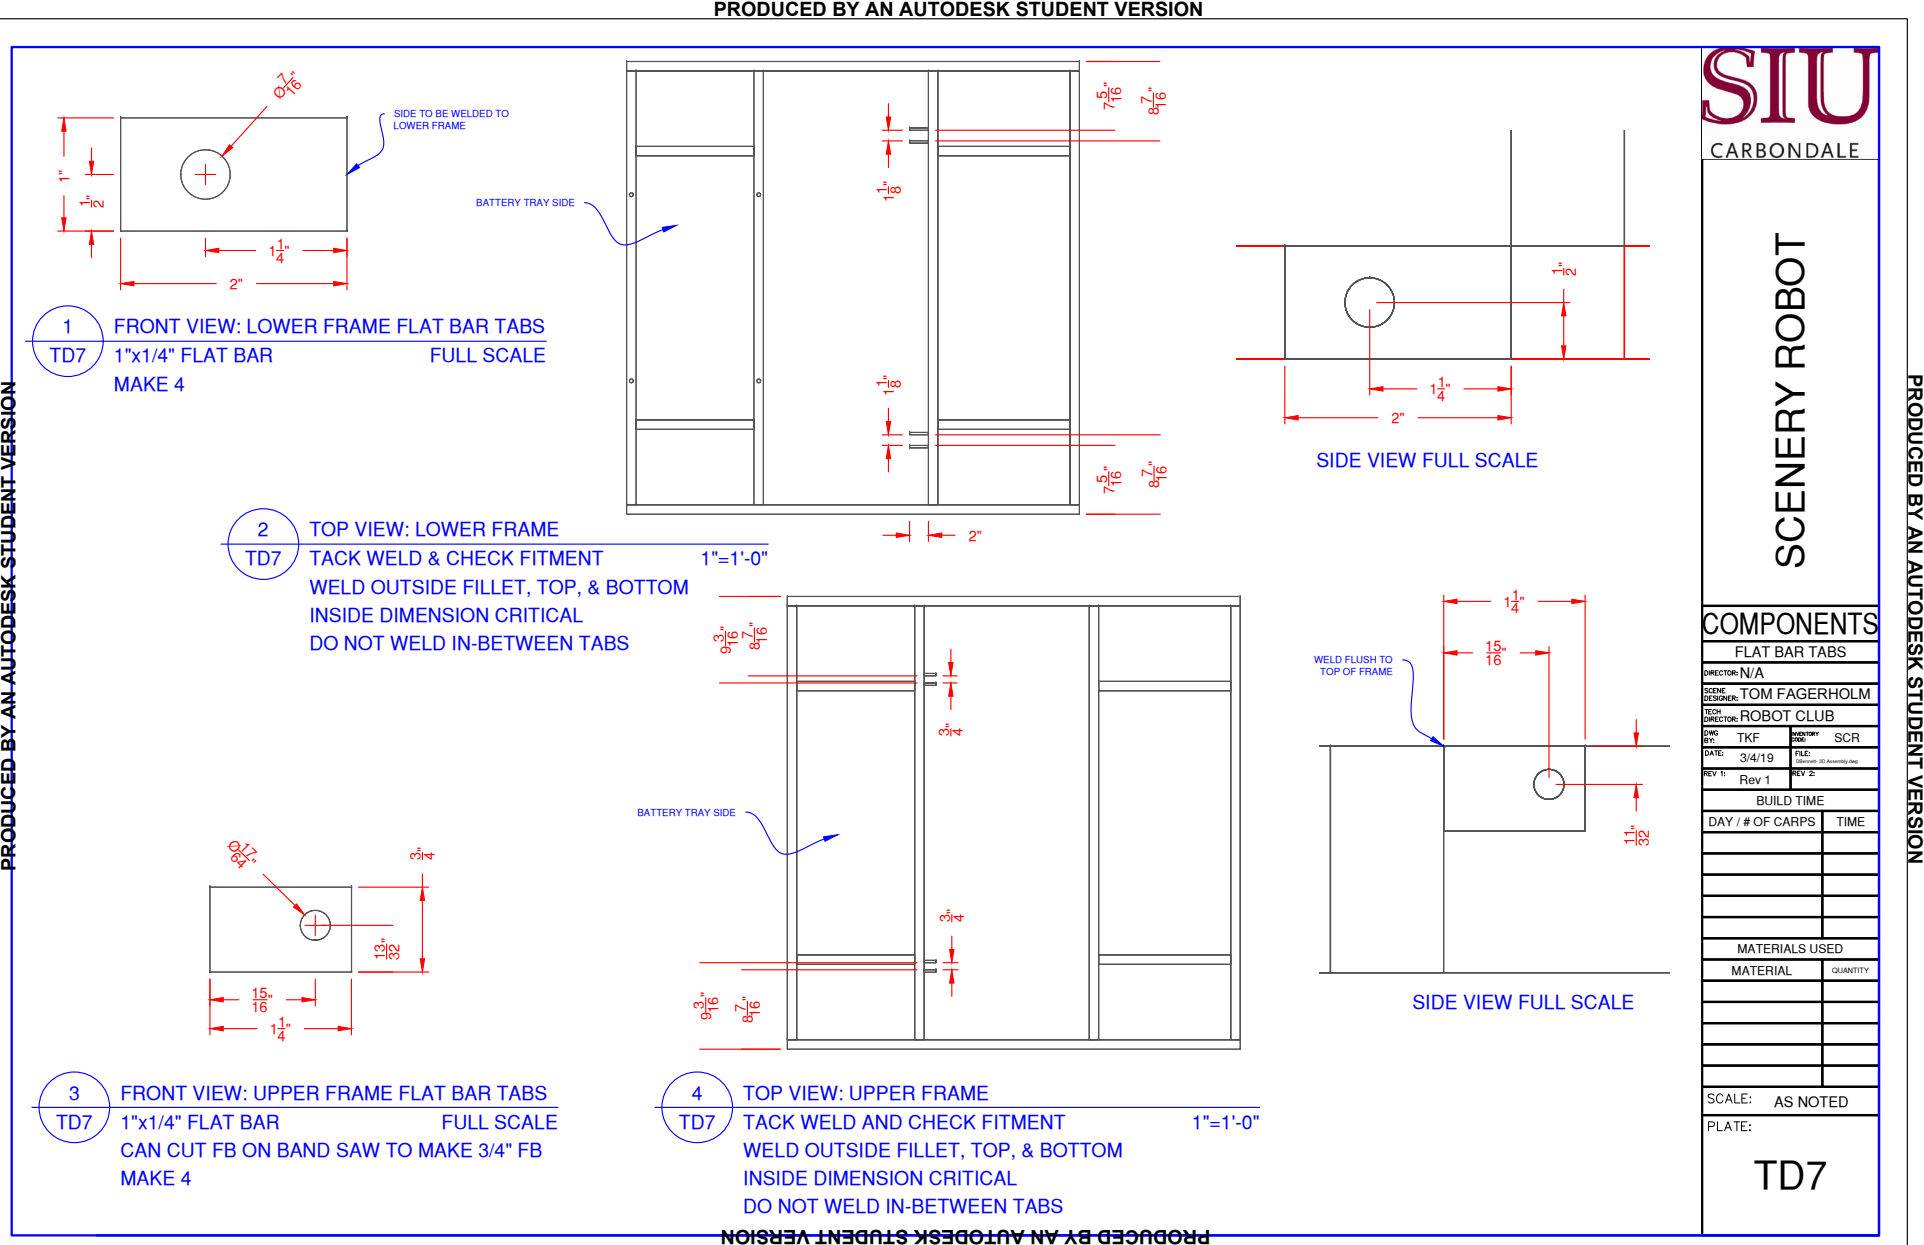
[picture p85: page 8]
MATERIAL; QUANTITY BUILD TIME DAY / # OF CARPS; TIME MATERIALS USED

PRODUCED BY AN AUTODESK STUDENT VERSION

32" 34" 1516"114"Ø 716" Ø1764" TD73 1"x1/4" FLAT BAR FRONT VIEW: UPPER FRAME FLAT BAR TABS FULL SCALE CAN CUT FB ON BAND SAW TO MAKE 3/4" FB MAKE 4 TD74 TACK WELD AND CHECK FITMENT TOP VIEW: UPPER FRAME 1"=1'-0" WELD OUTSIDE FILLET, TOP, & BOTTOM INSIDE DIMENSION CRITICAL DO NOT WELD IN-BETWEEN TABS 8 7

SCENERY ROBOT N/A ROBOT CLUB DBennett- 3D Assembly.dwg TOM FAGERHOLM TD7 AS NOTED Rev 1 3/4/19 TKF COMPONENTS FLAT BAR TABSSCR TD72 TACK WELD & CHECK FITMENT TOP VIEW: LOWER FRAME 1"=1'-0" WELD OUTSIDE FILLET, TOP, & BOTTOM INSIDE DIMENSION CRITICAL DO NOT WELD IN-BETWEEN TABS SIDE VIEW FULL SCALE TD71 1"x1/4" FLAT BAR FRONT VIEW: LOWER FRAME FLAT BAR TABS FULL SCALE MAKE 4 SIDE TO BE WELDED TO LOWER FRAME

1" 12" 114" 2" BATTERY TRAY SIDE 2" 7 5

32" 114" 2" 12" SIDE VIEW FULL SCALE

16" 34" 34" BATTERY TRAY SIDE WELD FLUSH TO TOP OF FRAME 1516"114"
