tfagerholm/SIU-Scenery-Robot-V1/(list of files, drawings)

Other design files:
EET Research/Edge Detection Documents/Edge Detection Schematic.fzz
EET Research/Final Schematic.fzz
