tfagerholm/SIU-Scenery-Robot-V1/Photos/20190201_011501298_iOS.jpg

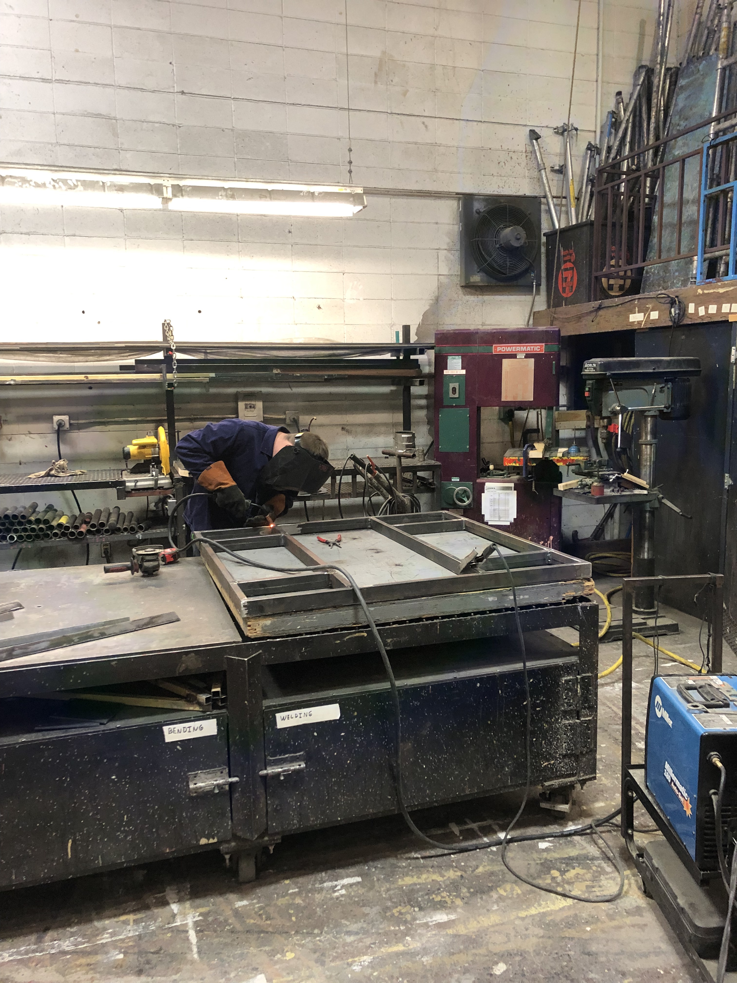
Photos/20190201_011501298_iOS.jpg
