tfagerholm/SIU-Scenery-Robot-V1/Photos/20190208_004355294_iOS.jpg

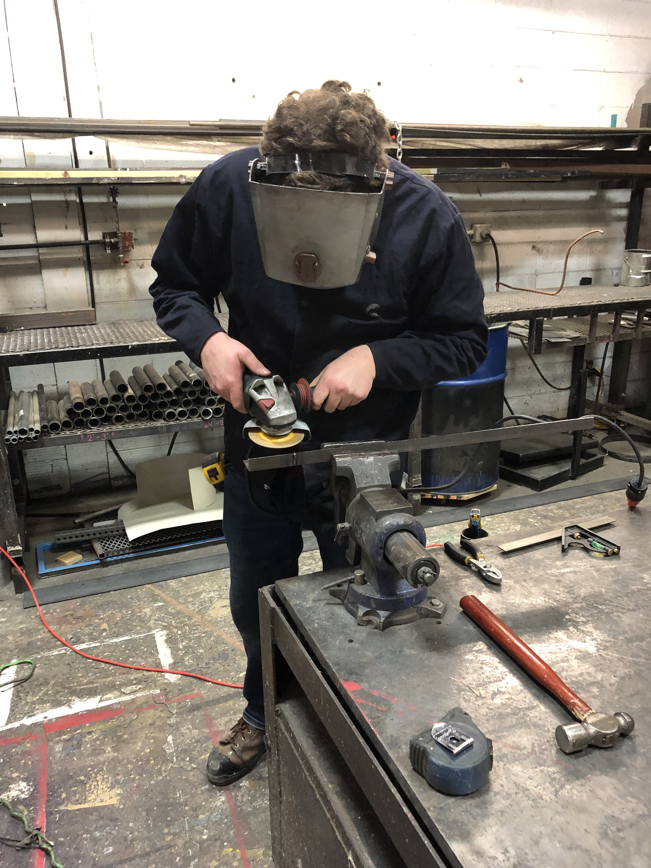
Photos/20190208_004355294_iOS.jpg
