tfagerholm/SIU-Scenery-Robot-V1/Photos/20190216_214225148_iOS.jpg

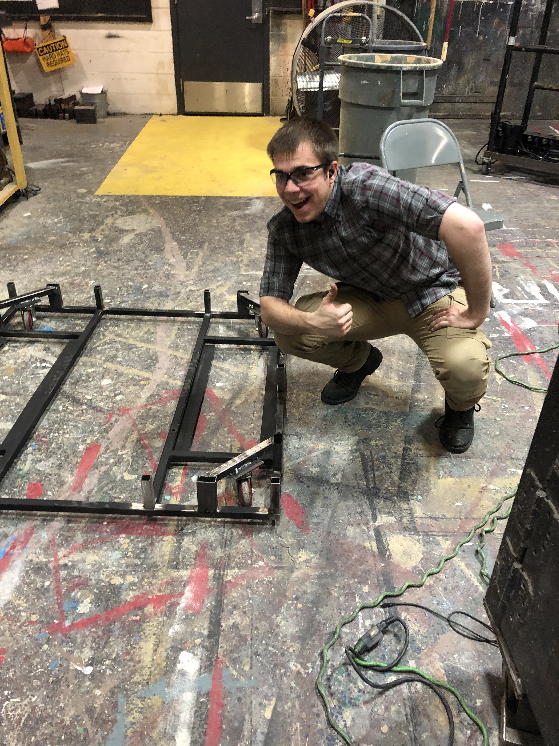
Photos/20190216_214225148_iOS.jpg
