tfagerholm/SIU-Scenery-Robot-V1/Photos/20190308_005900766_iOS.jpg

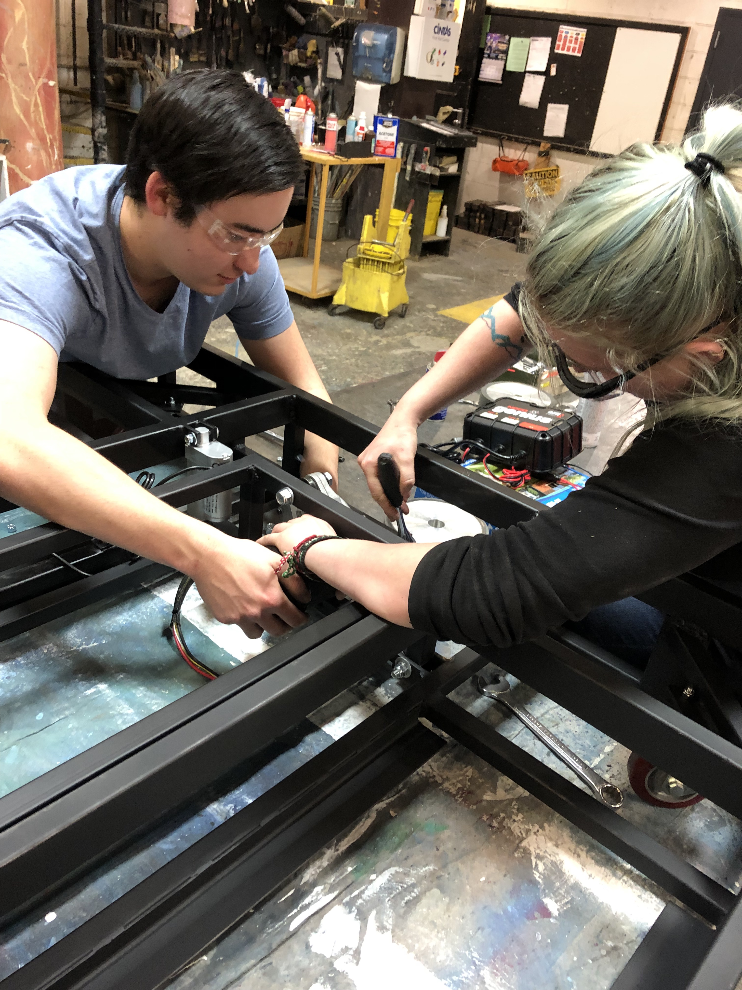
Photos/20190308_005900766_iOS.jpg
