tfagerholm/SIU-Scenery-Robot-V1/Photos/20190308_011111130_iOS.jpg

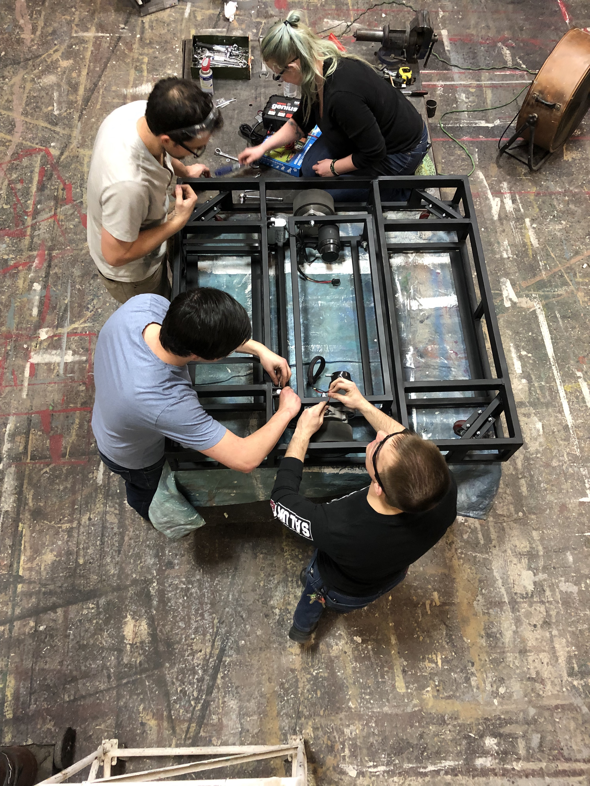
Photos/20190308_011111130_iOS.jpg
