tfagerholm/SIU-Scenery-Robot-V1/Photos/20190308_011116029_iOS.jpg

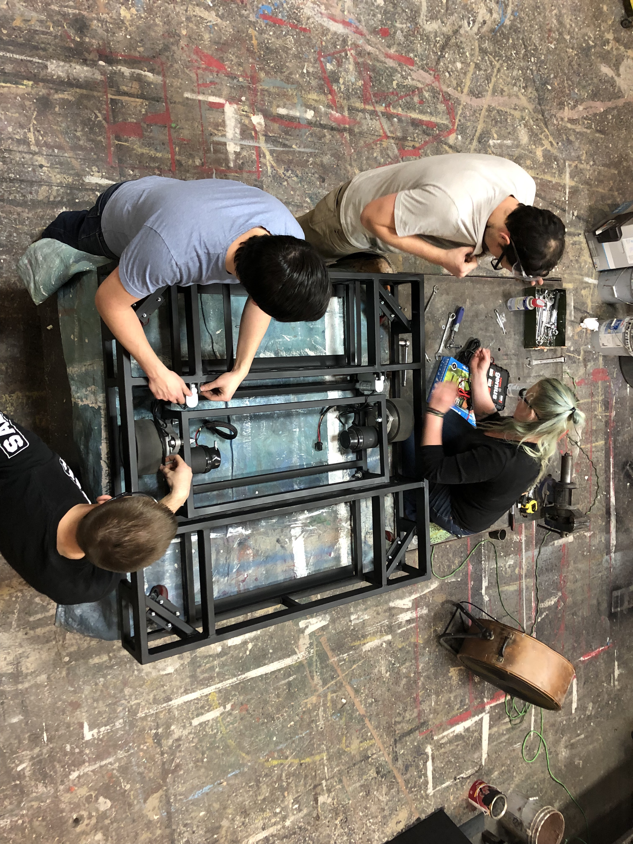
Photos/20190308_011116029_iOS.jpg
