tfagerholm/SIU-Scenery-Robot-V1/Photos/20190308_012318352_iOS.jpg

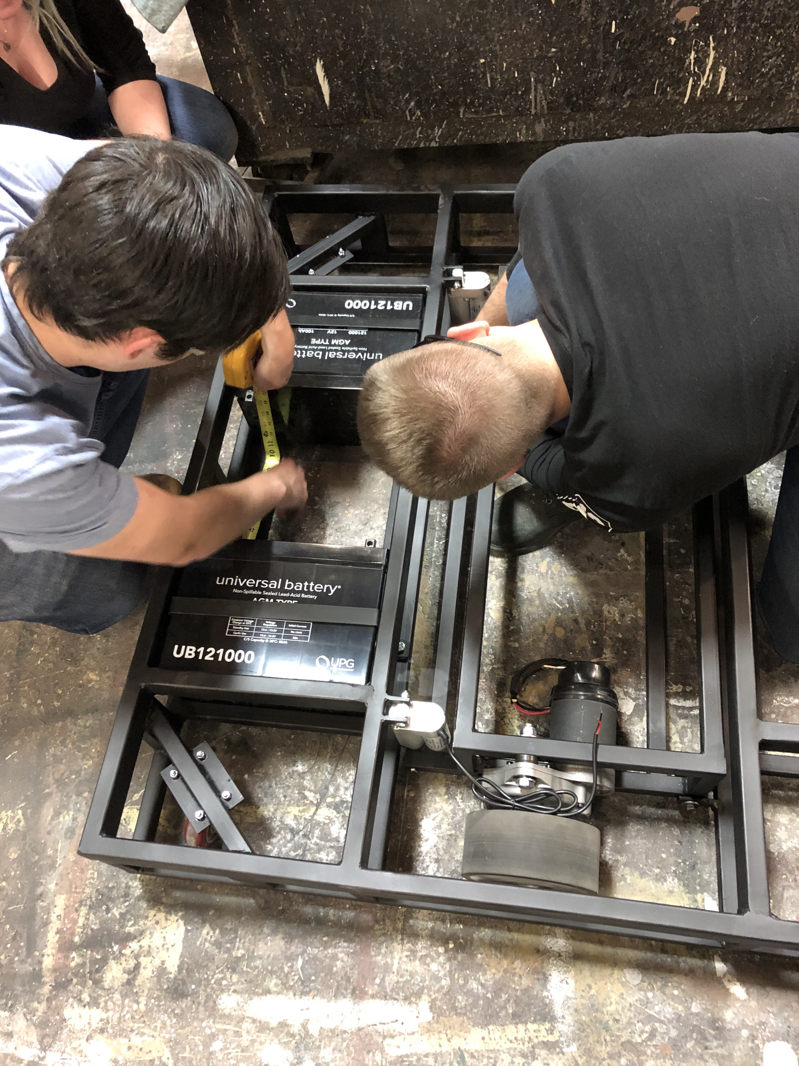
Photos/20190308_012318352_iOS.jpg
