tfagerholm/SIU-Scenery-Robot-V1/Photos/IMG_0386.JPG

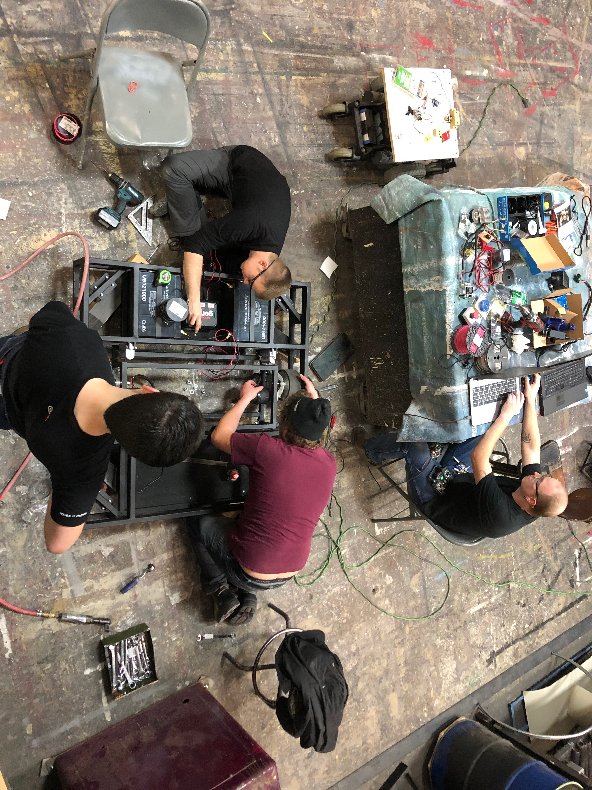
Photos/IMG_0386.JPG
