tfagerholm/SIU-Scenery-Robot-V1/Photos/IMG_0402.jpg

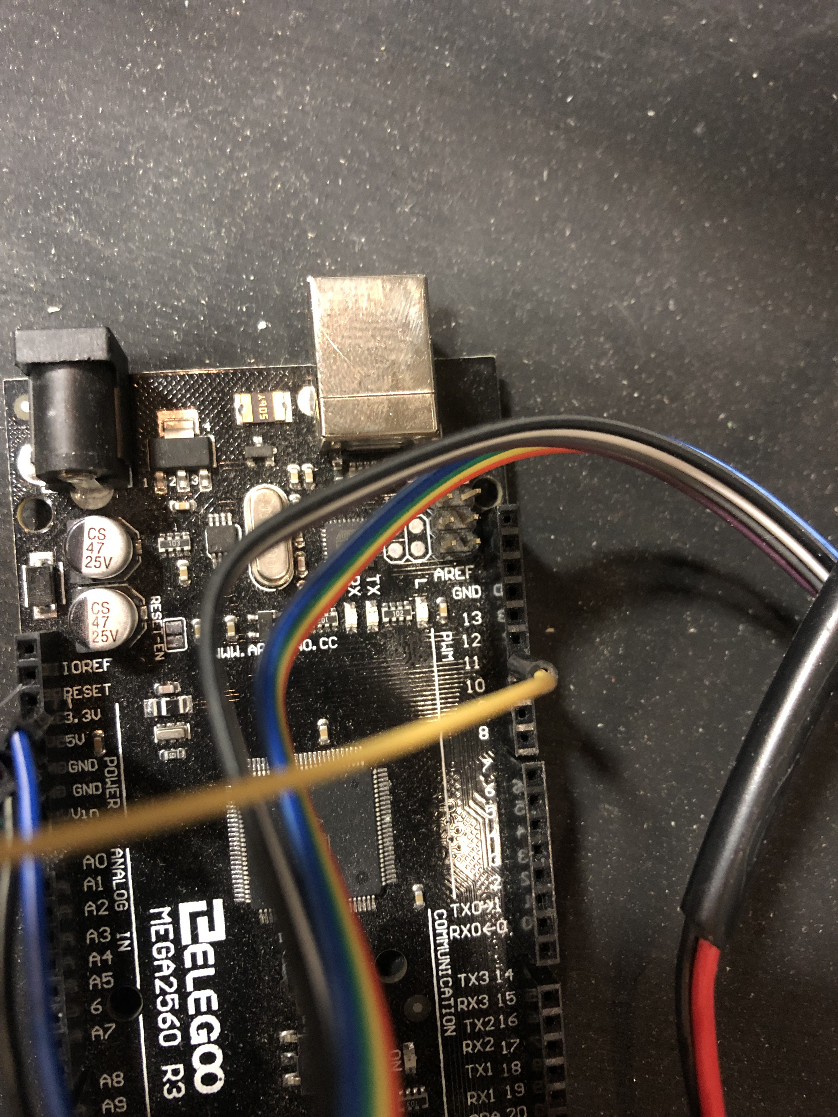
Photos/IMG_0402.jpg
