tfagerholm/SIU-Scenery-Robot-V1/Photos/IMG_0407.jpg

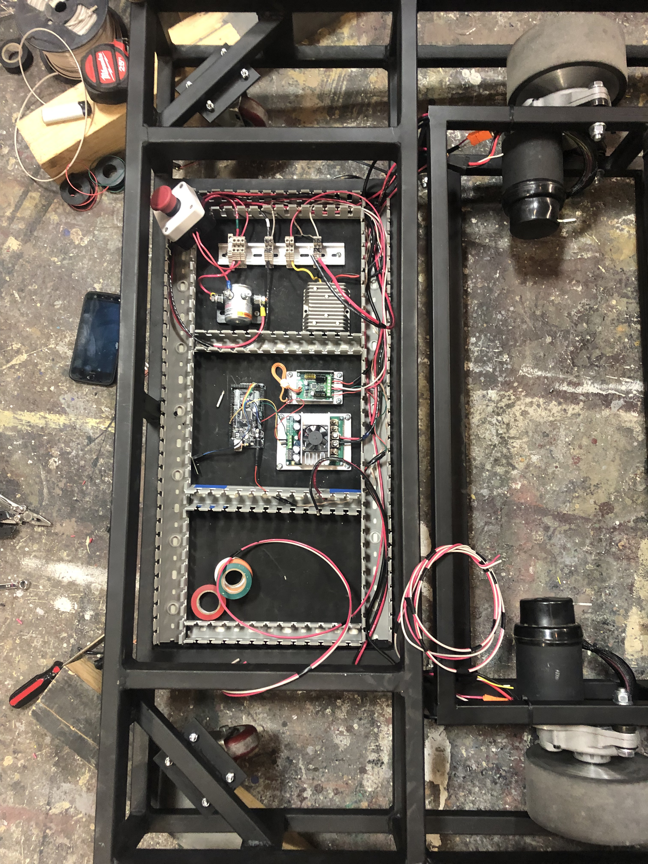
Photos/IMG_0407.jpg
