tfagerholm/SIU-Scenery-Robot-V1/Photos/IMG_0408.jpg

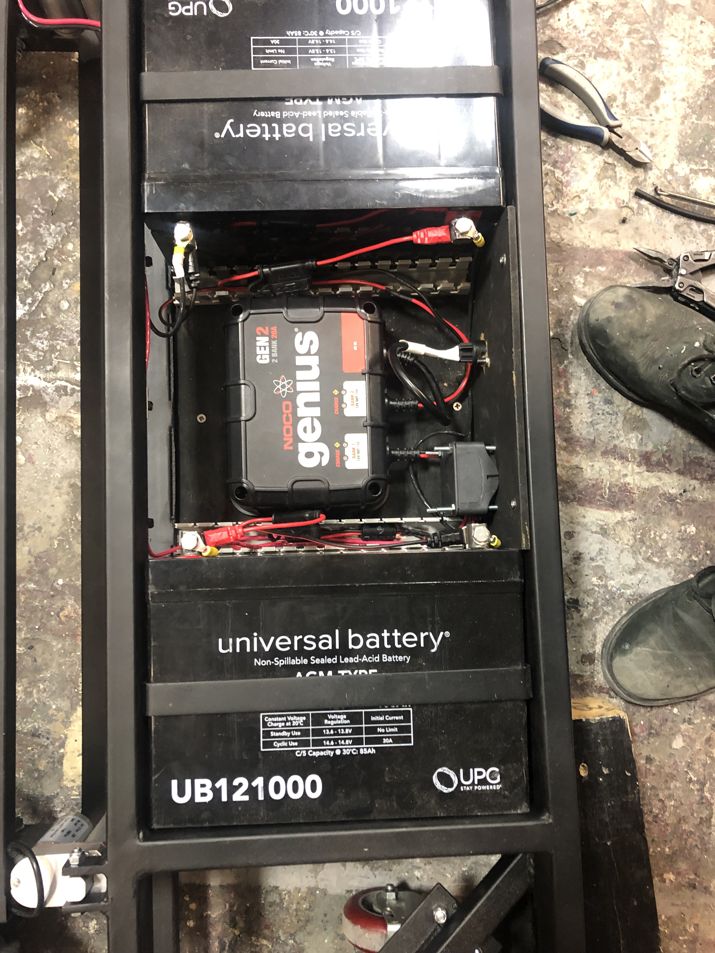
Photos/IMG_0408.jpg
