tfagerholm/SIU-Scenery-Robot-V1/Photos/IMG_0413.jpg

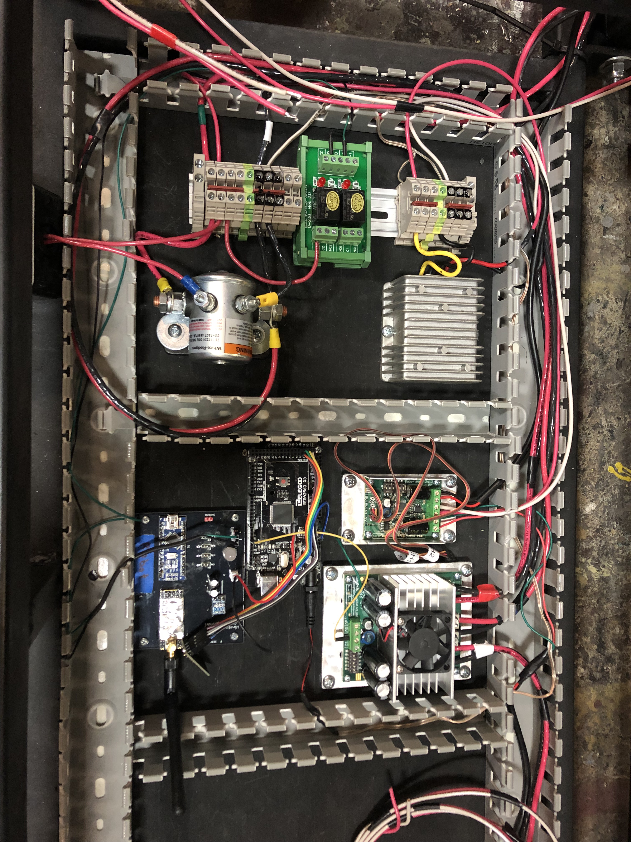
Photos/IMG_0413.jpg
