tfagerholm/SIU-Scenery-Robot-V1/Photos/IMG_0414.jpg

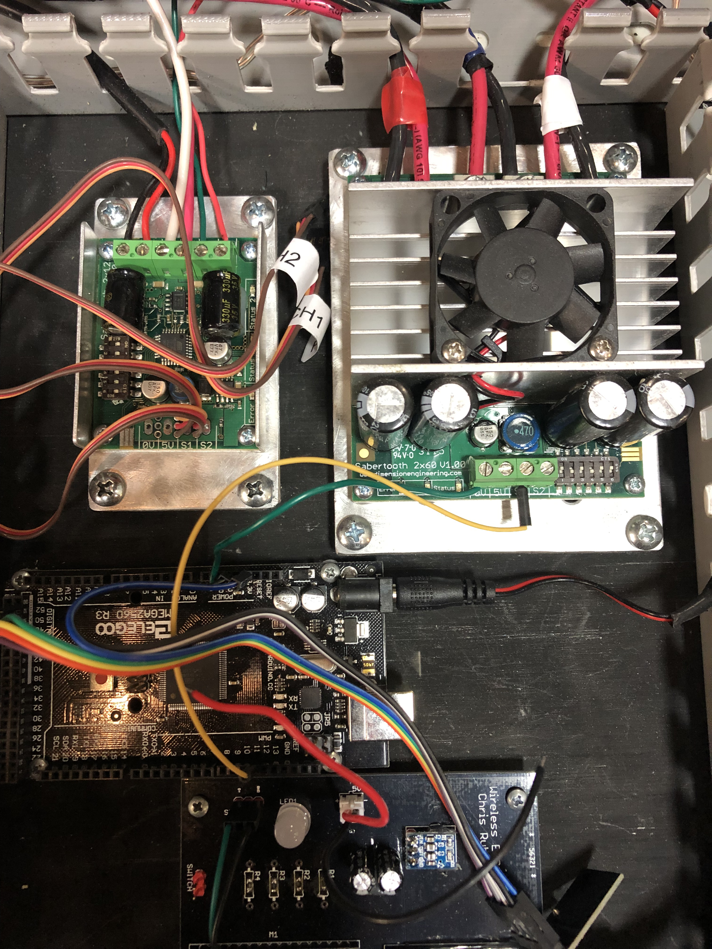
Photos/IMG_0414.jpg
