tfagerholm/SIU-Scenery-Robot-V1/Photos/IMG_0415.jpg

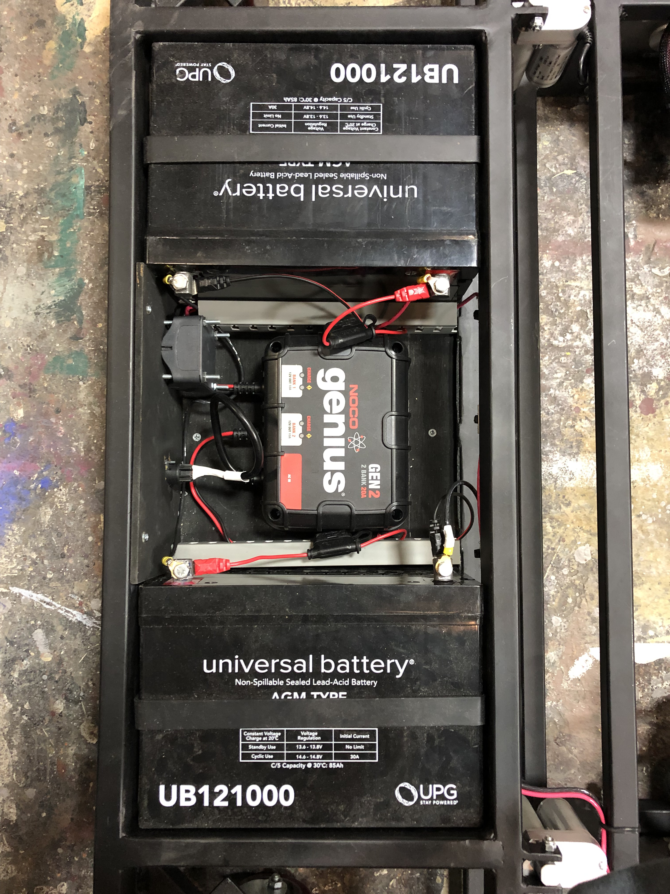
Photos/IMG_0415.jpg
